eSpark-Backup/briacbarthes-phonecharger/Deliverables/Renderings/3D_Bottom_View.PNG

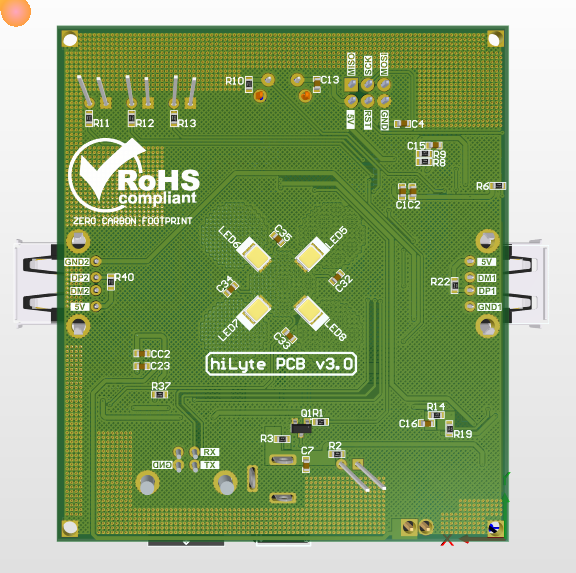
Deliverables/Renderings/3D_Bottom_View.PNG
