eSpark-Backup/briacbarthes-phonecharger/README.md

# BriacBarthes-PhoneCharger
To review and suggest further additions in client provided design of a Phone and Lamp Charger
### Circuit Issues and Proposed Corrections:
https://docs.google.com/document/d/1EhsSzwDODKwB_9vhH6Y4LQYS8pfnAFaaIl9aHzSk7XA/edit#
