eSpark-Backup/briacbarthes-phonecharger/Deliverables/Renderings/2D_Bottom_View.PNG

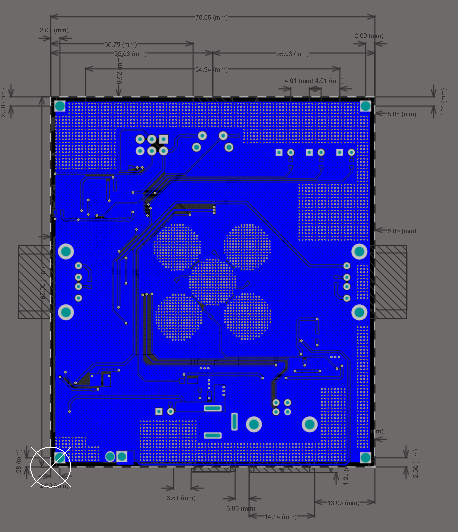
Deliverables/Renderings/2D_Bottom_View.PNG
