eSpark-Backup/briacbarthes-phonecharger/Deliverables/Renderings/2D_C_View.PNG

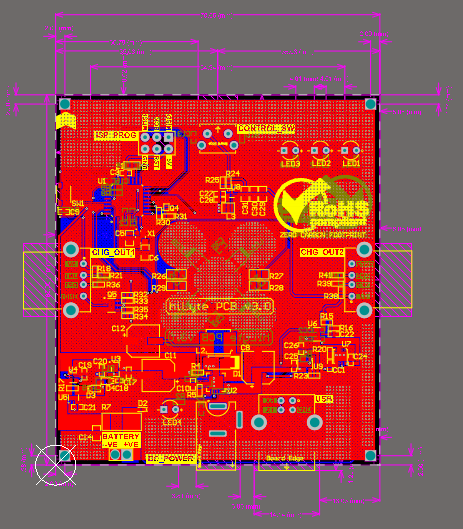
Deliverables/Renderings/2D_C_View.PNG
