eSpark-Backup/briacbarthes-phonecharger/Deliverables/Renderings/2D_Top_View.PNG

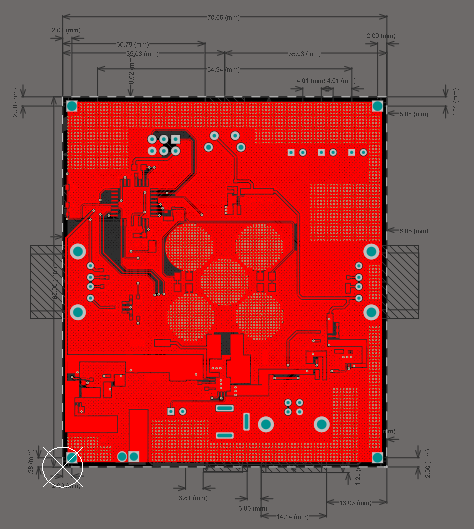
Deliverables/Renderings/2D_Top_View.PNG
