eSpark-Backup/briacbarthes-phonecharger/Deliverables/Renderings/Isometric_View.PNG

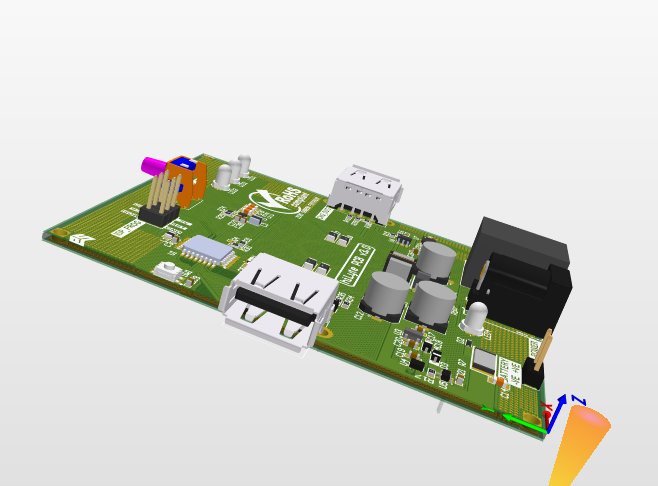
Deliverables/Renderings/Isometric_View.PNG
