eSpark-Backup/briacbarthes-phonecharger/Documents/Client-Files/WhatsApp Image 2021-10-05 at 18.15.51.jpeg

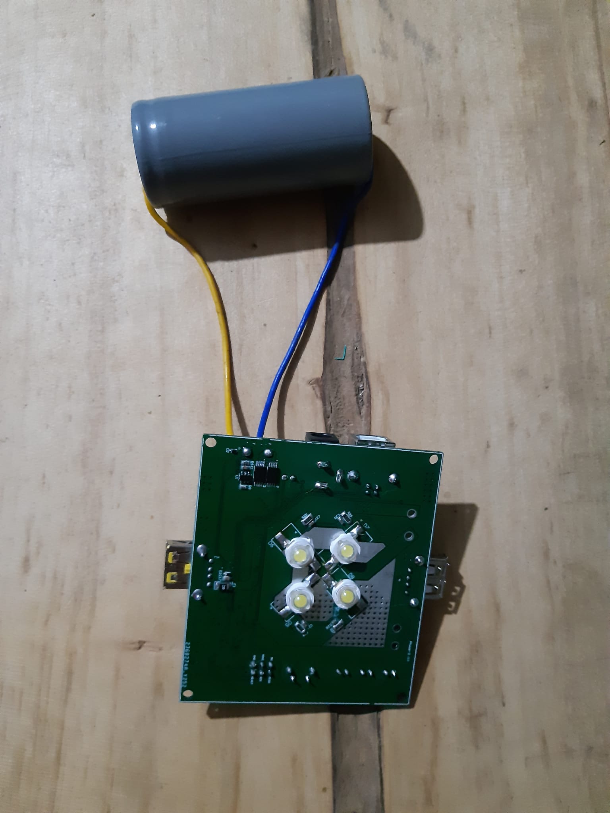
Documents/Client-Files/WhatsApp Image 2021-10-05 at 18.15.51.jpeg
