eSpark-Backup/briacbarthes-phonecharger/Documents/Client-Files/WhatsApp Image 2021-10-05 at 18.16.50.jpeg

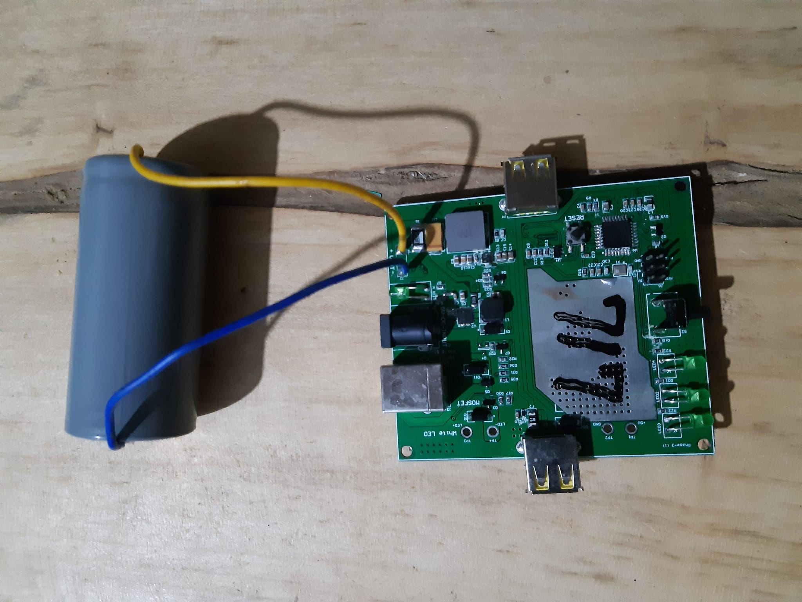
Documents/Client-Files/WhatsApp Image 2021-10-05 at 18.16.50.jpeg
