eSpark-Backup/briacbarthes-phonecharger/Documents/Dev-Files/Datasheet/FAgmp.png

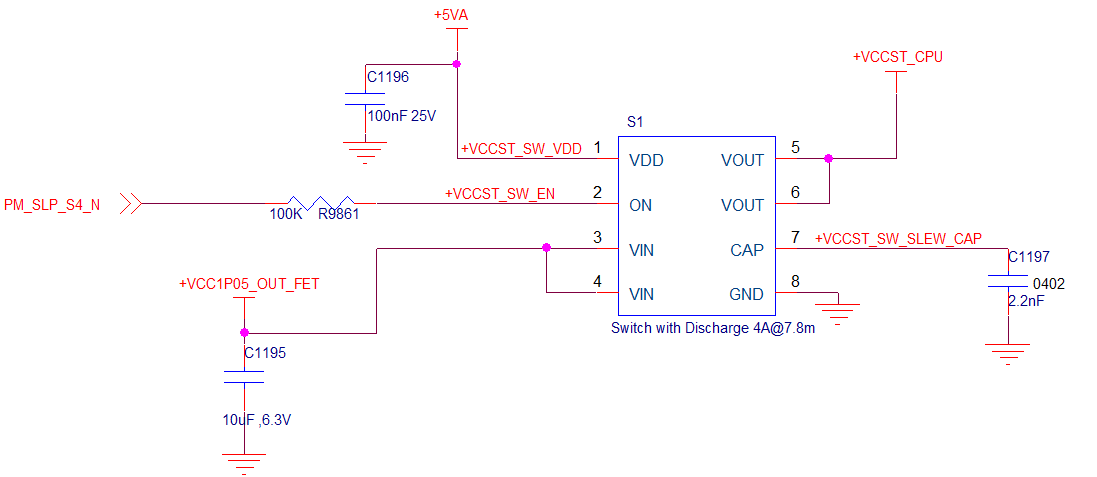
Documents/Dev-Files/Datasheet/FAgmp.png
