eSpark-Backup/briacbarthes-phonecharger/BOM/Client BOM.xlsx

Bill of Material (BOM) for Refrence Formate
S. No. | Components | Description | Designator | Footprint (Package) | Manufacturer Part Number | Manufacturer | LCSC Part No | Alternate | Value | LCSC/MOQ | Quantity (Per Board) | Quantity 10 | Quantity 20 | Quantity 500 | Quantity 1000 | Quantity 10000 | Unit Cost(10) | Total Cost(10) | Unit Cost (20 Boards) | Total Cost (20) | Unit Cost (500 Boards) | Total Cost (500) | Unit Cost (1000 Boards) | Total Cost (1000) | Unit Cost (10000 Boards) | Total Cost (10000) | Remarks
1 | Capacitor | CAP CER 0.1UF 50V X7R 0402 | C1,C10 | 0402 | 04025C104KAT2A | KYOCERA AVX | C110251 | 0402B104K500NT | 0.1uF | 50 | 1 | 50 | 50 | 550 | 1100 | 10500 | $0.0098 | $0.4900 | $0.0087 | $0.4350 | $0.0054 | $2.9700 | $0.0354 | $38.9400 | $0.0045 | $47.2500 | C10,wala part b same ha is lye merge kr dia 1 part no me
2 |  | Ceramic Capacitor,100nF,10V,0603 | C2, C17, C18, C19, C23, C24, C25, C26, C27, C28,C4, C8, C12, C20, C21, C22,Ce1,Ce2,Ce3,C31,C4 | 0603 | CC0603KRX7R6BB104 | YAGEO | C519438 | - | 100nF | 50 | 21 | 250 | 500 | 11000 | 22000 | 220000 | $0.0157 | $3.9250 | $0.0396 | $19.8000 | $0.0042 | $46.2000 | $0.0042 | $92.4000 | $0.0040 | $880.0000
3 |  | Ceramic Capacitor,22uF,10V,0805,X5R | C3, C9, C13, C14, C15 | 0805 | 0805X226M100NT | FH | C503482 | - | 22uF | 20 | 5 | 60 | 120 | 2650 | 5300 | 52000 | $0.0618 | $3.7080 | $0.0518 | $6.2160 | $0.0199 | $52.7350 | $0.0498 | $263.9400 | $0.0188 | $977.6000
4 |  | Tantalum capacitor 10uF 10V, CASE-A_3216 | C5, C6 | CASE-A_3216 | CA45-106K010AT | TANCAP | C327722 | - | 10uF | 5 | 2 | 25 | 45 | 1050 | 2100 | 21000 | $0.50750 | $12.6875 | $0.15750 | $7.0875 | $0.0880 | $92.4000 | $0.0764 | $160.4400 | $0.0739 | $1551.9000
5 |  | CAP CER 100PF 50V C0G 0603 | C7 | 0603 | CGA3E2C0G1H101JT0Y0N | TDK | C76709 | - | 100pF | 50 | 1 | 50 | 50 | 550 | 1050 | 10500 | $0.1159 | $5.7950 | $0.0159 | $0.7950 | $0.01 | $7.6450 | $0.09 | $94.2900 | $0.05 | $480.9000
6 |  | CAP TANT 150UF 10% 10V 2917 | C11 | CASE-D_7343 | T495D157K010ATE100 | KEMET | C122324 | - | 150uF | 1 | 1 | 12 | 23 | 525 | 1050 | 10200 | $0.7646 | $9.1752 | $0.7646 | $17.5858 | $0.6655 | $349.3875 | $0.6587 | $691.6350 | $0.6564 | $6695.2800
7 |  | CAP CER 10000PF 25V X7R 0603 | C16 | 0603 | 06033C103JAT4A | KYOCERA | C327204 |  | 10nF | 50 | 1 | 50 | 50 | 550 | 1100 | 10500 | $0.0549 | $2.7450 | $0.0049 | $0.2450 | $0.0039 | $2.1450 | $0.0655 | $72.0500 | $0.0236 | $247.8000
8 |  | CAP CER 1UF 25V X5R 0603 | Ce4 | 0603 | TMK107BLD105KA-T | Taiyo Yuden | C36577 | 0603F105M250NT | 1uF | 50 | 1 | 50 | 50 | 600 | 1050 | 10500 | $0.0285 | $1.4250 | $0.0768 | $3.8400 | $0.5500 | $330.0000 | $0.0466 | $48.9300 | $0.0741 | $778.0500
9 |  | Ceramic Capacitor,22pF,50V,0603 | C29, C30 | 0603 | FN18N220J500PSG | PSA | C525244 | - | 22pF | 100 | 2 | 100 | 100 | 1200 | 2200 | 21000 | $0.0031 | $0.3100 | $0.0031 | $0.3100 | $0.0023 | $2.7600 | $0.0823 | $181.0600 | $0.0545 | $1144.5000
10 | Diode | DIODE SCHOTTKY 40V 3A SMC | D1, D9, D10 | SMA | SS34 | onsemi | C8678 | - | - | 10 | 3 | 40 | 70 | 1600 | 3200 | 31500 | $0.0658 | $2.6320 | $0.0658 | $4.6060 | $0.0890 | $142.4000 | $0.0475 | $152.0000 | $0.0383 | $1206.4500
11 |  | TVS DIODE 5VWM 12.3VC SOD923 | D2, D3, D4 | SOD-923-2 | ESD9X5.0ST5G | onsemi | - | - | - | 10 | 3 | 35 | 70 | 1600 | 3100 | 30500 | $0.0369 | $1.2897 | $0.0369 | $2.5795 | $0.0236 | $37.7920 | $0.0297 | $91.9460 | $0.0224 | $684.4200
12 |  | Led Zpower Warm White 3000K 2SMD | D5, D6, D7, D8 | SMD/SMT | N42180-06-S2 | Seoul Semiconductor |  |  |  |  | 4 | 46 | 92 | 2300 | 4600 | 46000 |  | $0.0000 |  | $0.0000 |  | $0.0000 |  | $0.0000 |  | $0.0000
13 | Fuse | 6V 3.5A 1.5s SMD PTC Resettable Fuses | F1, F2 | Custom | SMD1206B200TF | Brightking | C269122 | - | - | 10 | 2 | 20 | 50 | 1050 | 2100 | 21000 | $0.0455 | $0.9100 | $0.0455 | $2.2750 | $0.0319 | $33.4950 | $0.0584 | $122.6400 | $0.0299 | $627.9000
14 | Inductor | 4.7uH ±20% 4A 26mΩ SMD,6x6x4.2mm Power Inductors RoHS | L1 | SMD,6x6x4.2mm | HPC6045NF-4R7MTH | TAI-TECH | C304373 | - | - | 5 | 1 | 10 | 25 | 525 | 1050 | 10500 | $0.0808 | $0.8080 | $0.0808 | $2.0200 | $0.05 | $28.8225 | $0.10 | $99.9600 | $0.05 | $544.9500
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
32 |  | Thick Film Resistor - 0.1ohm, 1%, 0.25W, 1206 | R24, R25, R26, R27 | 1206 | CR1206FR100P05R | Ever | C149672 | - | 0.1Ω | 50 | 4 | 50 | 100 | 2100 | 4200 | 41500 | $0.01 | $0.4650 | $0.01 | $0.9300 | $0.0088 | $18.4800 | $0.0069 | $28.9800 | $0.0162 | $672.3000
33 |  | RES SMD 400 OHM 0.1% 1/4W 1206 | RE3 | 1206 | RT1206BRD07400RL | YAGEO | C706413 | - | 400Ω | 5 | 1 | 10 | 25 | 525 | 1050 | 10500 | $0.0944 | $0.9440 | $0.0944 | $2.3600 | $0.0669 | $35.1225 | $0.0744 | $78.1200 | $0.0644 | $676.2000
34 | Switch | SPST 50mA @ 12VDC Top Actuated Round Button 160gf 4.5*4.5*5 Tactile Switch | S1 | 4.5X4.5X5mm_SMD | UK-B0206-G5-160-JZ | USAKRO | C620330 | - | - | 10 | 1 | 10 | 20 | 520 | 1050 | 10200 | $0.0560 | $0.5600 | $0.0660 | $1.3200 | $0.0496 | $25.7920 | $0.0677 | $71.0850 | $0.0358 | $365.1600
35 |  | SPST 50mA @ 12VDC Side operation Round Button Through Hole Tactile Switches | S2 | TH | SKHHLQA010 | ALPSALPINE | C125034 | - | - | 5 | 1 | 10 | 25 | 520 | 1050 | 10500 | $0.1308 | $1.3080 | $0.1378 | $3.4450 | $0.0868 | $45.1360 | $0.0838 | $87.9900 | $0.0855 | $897.7500
36 | Crystal | CRYSTAL 16.0000MHZ 12PF SMD | X1 | SMD-2520_4P | XXDPBISANF-16.000000 | Taitien |  |  |  |  | 1 | 12 | 23 | 575 | 1150 | 11500 |  | $0.0000 |  | $0.0000 |  | $0.0000 |  | $0.0000 |  | $0.0000
37 | IC | DW01A battery protection IC SOT-23-6 (Sunrom Product Code 4911) | U1 | SOT-23-6 | DW01A | PUOLOP | C351410 | - | - | 10 | 1 | 10 | 20 | 530 | 1050 | 10200 | $0.0604 | $0.6040 | $0.0684 | $1.3680 | $0.0466 | $24.6927 | $0.0789 | $82.8450 | $0.0383 | $390.6600
38 |  | QFN-16_4x4x065P PMIC - Battery Management RoHS | U2 | QFN-16_4x4x065P | TP5000-QFN16 | TOPPOWER | C51699 | - | - | 1 | 1 | 11 | 22 | 520 | 1050 | 10200 | $0.2844 | $3.1284 | $0.2874 | $6.3228 | $0.2790 | $145.0800 | $0.3429 | $360.0450 | $0.2416 | $2464.3200
39 |  | Dual N-Channel Mosfet TSSOP-8 (Sunrom Product Code 5292) | U3 | TSSOP-8 | FS8205A | Fortune | C16052 | - | - | 1 | 1 | 11 | 22 | 520 | 1050 | 10200 | $0.1683 | $1.8513 | $0.1898 | $4.1756 | $0.1498 | $77.8960 | $0.1159 | $121.6950 | $0.1650 | $1683.0000
40 |  | IC CURR SENSE 1 CIRCUIT SOT23-6 | U4 | SOT-23-6 | INA181A3IDBVR | Texas | - | - | - | 10 | 1 | 11 | 22 | 520 | 1110 | 11100 | $1.0900 | $11.9900 | $0.9700 | $21.3400 | $0.8954 | $465.6000 |  | $0.0000 |  | $0.0000
41 |  | IC REG BOOST 5.1V 6.5A 9VQFN | U5 | VQFN-9 | TPS61235PRWLR | Texas | - | - | - | 10 | 1 | 11 | 22 | 520 | 1050 | 10200 | $2.5030 | $27.5330 | $2.2114 | $48.6500 | $1.9239 | $1000.4200 | $2.4960 | $2620.8000 |  | $0.0000
42 |  | MICROCHIP - ATMEGA328P-AU. - MICROCONTROLLER MCU, 8 BIT, ATMEGA, 20MHZ, TQFP-32 | U6 | TQFP-32 | ATMEGA328P-AU | Microchip | C14877 | - | - | 1 | 1 | 11 | 22 | 510 | 1020 | 10100 | $3.8122 | $41.9342 | $3.8122 | $83.8684 | $3.6945 | $1884.1950 | $3.0587 | $3119.8740 | $3.0125 | $30426.2500
43 |  | IC OR CTRLR SRC SELECT 8TSSOP | U7 | 8-TSSOP | TISTPS2111APWR | Texas |  |  |  |  | 1 | 11 | 22 | 555 | 1110 | 11100 |  | $0.0000 |  | $0.0000 |  | $0.0000 |  | $0.0000 |  | $0.0000
44 |  | IC PWR SWITCH P-CHAN 1:1 4TMLF | U8 | 4-TMLF | MIC94082YFT-TR | Microchip | - | - | - | 65 | 1 | 65 | 65 | 520 | 1050 | 10200 | $0.8650 | $56.2250 | $0.9050 | $58.8250 | $0.8800 | $457.6000 | $0.7800 | $819.0000 | $0.8580 | $8751.6000
45 | Connector | CONN PWR JACK 2.1X5.5MM SOLDER | J1 | TH | 694106301002 | Würth |  |  |  |  | 1 | 10 | 20 | 500 | 1000 | 10000 |  | $0.0000 |  | $0.0000 |  | $0.0000 |  | $0.0000 |  | $0.0000
46 |  | USB B-type Female Right Angle PCB Mount | J3 | TH | Sunrom 3966 | Sunrom | - | - | - | 10 | 1 | 10 | 22 | 520 | 1050 | 10100 | $0.2200 | $2.2000 | $0.2200 | $4.8400 | $0.9100 | $473.2000 | $0.5440 | $571.2000 | $0.7000 | $7070.0000
47 |  | CONN RCPT USB2.0 TYPEA 4POS R/A | J4, J5 | TH | 292303-1 | TE | - | - | - | 60 | 2 | 60 | 60 | 1050 | 2100 | 20500 | $0.9070 | $54.4200 | $0.9872 | $59.2320 | $0.6650 | $698.2500 | $0.6997 | $1469.3700 | $0.6750 | $13837.5000
48 |  | Pin Header 6P 2 right-angle, P=2.54mm | J6 | TH 2.54MM | PZ254V-12-6P | XFCN | C492420 | - | - | 20 | 1 | 20 | 20 | 520 | 1160 | 10200 | $0.07 | $1.3020 | $0.06 | $1.1020 | $0.9900 | $514.8000 | $0.0579 | $67.1640 | $0.0178 | $181.5600
 |  |  |  |  |  |  |  |  |  |  | Total Component Cost |  |  |  |  |  |  | $265.21 |  | $407.84 |  | $8440.43 |  | $13198.70 |  | $90954.99
 |  |  |  |  |  |  |  |  |  |  | Single Board Cost |  |  |  |  |  |  | $26.52 |  | $20.39 |  | $16.88 |  | $13.20 |  | $9.10
