eSpark-Backup/briacbarthes-phonecharger/Deliverables/BOM/Client-BOM.xlsx

Bill of Material (BOM) for Briac
S. No. | Components | Description | Designator | Footprint (Package) | Manufacturer Part Number | Manufacturer | Alternate | Value | LCSC MOQ (1Board) | MOQ (5 boards) | MOQ (100 boards) | MOQ (1000 boards) | Quantity (per Board) | Quantity 5 | Quantity 100 | Quantity 1000 | Link | Unit Cost(5) | Total Cost(5) | Unit Cost (100 Boards) | Total Cost (100) | Unit cost (1000) | Total Cost(1000) | Remarks
1 | Capacitor | CAP CER 0.1UF 50V Y5V 0603 | C1, C2, C3, C4, C7, C9, C10, C13, C15, C20, C21, C22, C23, C24, C25, C26, C32, C33, C34, C35, CC1, CC2 | Cap0603 | CC0603ZRY5V9BB104 | Yageo | ----------- | 0.1uF | 100 | 200 | 2300 | 22500 | 22 | 110 | 2200 | 22000 | LCSC (https://lcsc.com/product-detail/Multilayer-Ceramic-Capacitors-MLCC-SMD-SMT_YAGEO-CC0603ZRY5V9BB104_C106221.html) | $0.0033 | $0.6600 | $0.0024 | $5.5200 | $0.0021 | $47.2500
2 |  | CAP CER 22UF 35V X5R 0805 | C5, C6, C14, C29, C30, C31 | Cap0805 | C2012X5R1V226MT000E | TDK Corporation | -------- | 22uF | 10 | 35 | 650 | 6100 | 6 | 30 | 600 | 6000 | LCSC (https://lcsc.com/product-detail/Multilayer-Ceramic-Capacitors-MLCC-SMD-SMT_TDK-C2012X5R1V226MT000E_C338080.html) | $0.2561 | $8.9635 | $0.2090 | $135.8500 | $0.2073 | $1264.5300
3 |  | CAP ALUM 10UF 20% 50V SMD | C8, C11, C12 | Custom | UWX1H100MCL1GB | Nichicon | -------- | 10uF | 5 | 20 | 350 | 3100 | 3 | 15 | 300 | 3000 | Custom Supplier (https://lcsc.com/product-detail/Aluminum-Electrolytic-Capacitors-SMD_Nichicon-UWX1H100MCL1GB_C134237.html) | $0.0830 | $1.6600 | $0.0609 | $21.3150 | $0.06 | $173.2900
4 |  | CAP CER 100PF 25V C0G/NPO 0603 | C16 | Cap0603 | CC0603JRNPO8BN101 | Yageo | -------- | 100pF | 50 | 50 | 150 | 1100 | 1 | 5 | 100 | 1000 | LCSC (https://lcsc.com/product-detail/Multilayer-Ceramic-Capacitors-MLCC-SMD-SMT_YAGEO-CC0603JRNPO8BN101_C519387.html) | $0.0040 | $0.2000 | $0.0040 | $0.6000 | $0.0031 | $3.4100
5 |  | CAP CER 1UF 25V Y5V 0603 | C17, C28 | Cap0603 | CC0603ZRY5V8BB105 | Yageo | -------- | 1uF | 50 | 50 | 250 | 2100 | 2 | 10 | 200 | 2000 | LCSC (https://lcsc.com/product-detail/Multilayer-Ceramic-Capacitors-MLCC-SMD-SMT_YAGEO-CC0603ZRY5V8BB105_C106848.html) | $0.0097 | $0.4850 | $0.0097 | $2.4250 | $0.0071 | $14.9100
6 |  | CAP CER 0402 2.2NF 25V C0G 5% | C18 | Cap 0402 | ~~C0402C222J3GEC7867~~ | KEMET | CC0402KRX7R8BB222 | 2.2nF | 100 | 100 | 200 | 1100 | 1 | 5 | 100 | 1000 | LCSC (https://lcsc.com/product-detail/Multilayer-Ceramic-Capacitors-MLCC-SMD-SMT_YAGEO-CC0402KRX7R8BB222_C541386.html) | $0.0015 | $0.1500 | $0.0015 | $0.3000 | $0.0012 | $1.3200
7 |  | CAP CER 10UF 25V X5R 0603 | C19, C27 | Cap0603 | CC0603MRX5R8BB106 | Yageo | -------- | 10uF | 5 | 15 | 230 | 2100 | 2 | 10 | 200 | 2000 | LCSC (https://lcsc.com/product-detail/Multilayer-Ceramic-Capacitors-MLCC-SMD-SMT_YAGEO-CC0603MRX5R8BB106_C596327.html) | $0.0906 | $1.3590 | $0.0683 | $15.7090 | $0.0648 | $136.0800
8 |  | CAP CER 1000PF 10V X7R 0603 | C39 | Cap0603 | ~~0603ZC102KAT2A~~ | KYOCERA AVX | CC0603KRX7R6BB102 | 1000pF | 50 | 50 | 150 | 1100 | 1 | 5 | 100 | 1000 | LCSC (https://lcsc.com/product-detail/Multilayer-Ceramic-Capacitors-MLCC-SMD-SMT_YAGEO-CC0603KRX7R6BB102_C519402.html) | $0.0043 | $0.2150 | $0.0043 | $0.6450 | $0.0033 | $3.6300
9 | Diode | 40V 500mV 3A 3A SMA Schottky Barrier Diodes (SBD) | D1 | SMA | SS34 | LGE | -------- | -------- | 10 | 10 | 120 | 1100 | 1 | 5 | 100 | 1000 | LCSC (https://lcsc.com/product-detail/Schottky-Barrier-Diodes-SBD_LGE-SS34_C432300.html) | $0.0755 | $0.7550 | $0.0579 | $6.9480 | $0.0422 | $46.4200
10 |  | SOD-523 ESD Protection Devices ROHS | D2 | SOD-523 | LESD5Z5.0CT1G | LRC | -------- | -------- | 20 | 20 | 120 | 1100 | 1 | 5 | 100 | 1000 | LCSC (https://lcsc.com/product-detail/span-style-background-color-ff0-ESD-span-Protection-Devices_LRC-LESD5Z5-0CT1G_C136167.html) | $0.0183 | $0.3660 | $0.0183 | $2.1960 | $0.0123 | $13.5300
11 |  | DIODE SCHOTTKY 20V 2A SOD323 | D3, D4 | SOD323 | SDM2U20SD3-7 | Diodes | -------- | -------- | 5 | 15 | 230 | 2100 | 2 | 10 | 200 | 2000 | LCSC (https://lcsc.com/product-detail/Schottky-Barrier-Diodes-SBD_Diodes-Incorporated-SDM2U20SD3-7_C460258.html) | $0.1087 | $1.6305 | $0.0772 | $17.7560 | $0.0723 | $151.8300
12 | Inductor | 500mA 10uH ±20% 320mΩ 0805 Inductors | L1 | Ind0805 | MGFL2012F100MT-LF | microgate | -------- | 10uH | 10 | 10 | 120 | 1100 | 1 | 5 | 100 | 1000 | LCSC (https://lcsc.com/product-detail/Inductors-SMD_microgate-MGFL2012F100MT-LF_C281113.html) | $0.0459 | $0.4590 | $0.0360 | $4.3200 | $0.0324 | $35.6400
13 |  | FIXED IND 4.7UH 3.1A 37.7MOHM SM | L2 | Custom | NR5040T4R7N | Taiyo Yuden | -------- | 4.7uH | 2 | 8 | 113 | 1100 | 1 | 5 | 100 | 1000 | Custom Supplier | $1.2000 | $9.6000 | $1.2000 | $135.6000 | $1.2000 | $1320.0000
14 |  | FIXED IND 1UH 3A 59 MOHM SMD | L3 | Custom | 1239AS-H-1R0M=P2 | Murata | -------- | 1uH | 5 | 10 | 120 | 1100 | 1 | 5 | 100 | 1000 | LCSC (https://lcsc.com/product-detail/Inductors-SMD_Murata-Electronics-1239AS-H-1R0M-P2_C167447.html) | $0.0703 | $0.7030 | $0.0512 | $6.1440 | $0.0442 | $48.6200
15 | LED | Yellow-Green 0402 Light Emitting Diodes | LED1, LED2, LED3, LED4 | LED 0402 | TZ-P2-0402YGTIA1-0.45T | TUOZHAN | -------- | -------- | 50 | 50 | 450 | 4100 | 4 | 20 | 400 | 4000 | LCSC (https://lcsc.com/product-detail/Light-Emitting-Diodes-LED_TUOZHAN-TZ-P2-0402YGTIA1-0-45T_C688878.html) | $0.0152 | $0.7600 | $0.0152 | $6.8400 | $0.0110 | $45.1000
16 |  | SMD LED 2835 Chips 1W 3V SMD | LED5, LED6, LED7, LED8 | 2835 LED | -------------- | XINGLIGHT | -------- | ------- | 50 | 50 | 450 | 4100 | 4 | 20 | 400 | 4000 | LCSC (https://lcsc.com/product-detail/Light-Emitting-Diodes-span-style-background-color-ff0-LED-span_XINGLIGHT-XL-2835UWC-02_C2843876.html) | $0.0086 | $0.4300 | $0.0086 | $3.8700 | $0.0059 | $24.1900
17 | Mosfet | SI2302 Series 20 3 A N-Ch Enhancement Mode Field Effect Transistor - SOT-23-3 | Q1 | SOT-23 | SI2302-TP | Micro | -------- | -------- | 10 | 10 | 200 | 1100 | 1 | 5 | 100 | 1000 | Aliexpress (https://www.aliexpress.com/item/32994205247.html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) | $0.0323 | $0.3230 | $0.0374 | $7.4800 | $0.0295 | $32.4500
18 |  | 2 N-Channel 466pF 10V 5.7nC 10V +150℃ (Tj) SOT23-6 MOSFETs | Q5 | SOT-23-6 | FS8205A | TECH | -------- | -------- | 10 | 10 | 110 | 1100 | 1 | 5 | 100 | 1000 | LCSC (https://lcsc.com/product-detail/MOSFETs_TECH-PUBLIC-FS8205A_C2830320.html) | $0.0615 | $0.6150 | $0.0453 | $4.9830 | $0.0363 | $39.9300
19 |  | Mosfet N-ch 12V 3.2A 3-PIN X2-DFN T/r | Q4 | X2-DFN1010-3 | DMN1045UFR4-7 | Diodes | -------- | -------- | 2 | 8 | 120 | 1100 | 1 | 5 | 100 | 1000 | Custom Supplier | $0.8000 | $6.4000 | $0.8000 | $96.0000 | $0.8000 | $880.0000
20 | Resistor | RES SMD 1K OHM 1% 1/10W 0603 | R1, R2, R30, R32, R34 | Res0603 | RC0603FR-071KL | YAGEO | -------- | 1K | 100 | 100 | 600 | 5200 | 5 | 25 | 500 | 5000 | LCSC (https://lcsc.com/product-detail/Chip-Resistor-Surface-Mount_YAGEO-RC0603FR-071KL_C22548.html) | $0.0012 | $0.1200 | $0.0012 | $0.7200 | $0.0009 | $4.6800
21 |  | RES SMD 100K OHM 1% 1/10W 0603 | R3, R25, R31, R33, R35, R37 | Res0603 | RC0603FR-07100KL | YAGEO | -------- | 100K | 100 | 100 | 700 | 6200 | 6 | 30 | 600 | 6000 | LCSC (https://lcsc.com/product-detail/Chip-Resistor-Surface-Mount_YAGEO-RC0603FR-07100KL_C14675.html) | $0.0011 | $0.1100 | $0.0011 | $0.7700 | $0.0008 | $4.9600
22 |  | RES 0.05 OHM 1% 1/10W 0603 | R4 | Res0603 | ~~WSL0603R0500FEA~~ | Vishay Dale | RTT03R050FTP | 0.05R | 50 | 50 | 150 | 1100 | 1 | 5 | 100 | 1000 | LCSC (https://lcsc.com/product-detail/Chip-span-style-background-color-ff0-Resistor-span-Surface-Mount_RALEC-RTT03R050FTP_C158895.html) | $0.0092 | $0.4600 | $0.0092 | $1.3800 | $0.0069 | $7.5900
23 |  | RES SMD 0R, 1%, 0.1W, 0603 | R5 | Res0603 | RC0603FR-070RL | YAGEO | -------- | 0R | 100 | 100 | 200 | 1100 | 1 | 5 | 100 | 1000 | LCSC (https://lcsc.com/product-detail/Chip-Resistor-Surface-Mount_YAGEO-RC0603FR-070RL_C100044.html) | $0.0011 | $0.1100 | $0.0011 | $0.2200 | $0.0008 | $0.8800
24 |  | RES SMD 10K OHM 5% 1/10W 0603 | R6, R10, R15, R16, R17, R19, R23 | Res0603 | AC0603JR-0710KL | YAGEO | -------- | 10K | 100 | 100 | 800 | 7100 | 7 | 35 | 700 | 7000 | LCSC (https://lcsc.com/product-detail/Chip-Resistor-Surface-Mount_YAGEO-AC0603JR-0710KL_C140867.html) | $0.0014 | $0.1400 | $0.0014 | $1.1200 | $0.0010 | $7.1000
25 |  | RES 0.001 OHM 5% 2W 2512 | R7 | RES 2512 | PA2512JKF7W0R001E | YAGEO | -------- | 0.001R | 5 | 10 | 120 | 1100 | 1 | 5 | 100 | 1000 | LCSC (https://lcsc.com/product-detail/Chip-Resistor-Surface-Mount_YAGEO-PA2512JKF7W0R001E_C728356.html) | $0.1472 | $1.4720 | $0.1131 | $13.5720 | $0.0825 | $90.7500
26 |  | RES SMD 12K OHM 1% 1/10W 0603 | R8 | Res0603 | ERJ3EKF1202V | Panasonic | -------- | 12K | 50 | 50 | 150 | 1100 | 1 | 5 | 100 | 1000 | LCSC (https://lcsc.com/product-detail/Chip-Resistor-Surface-Mount_PANASONIC-ERJ3EKF1202V_C400645.html) | $0.0084 | $0.4200 | $0.0084 | $1.2600 | $0.0062 | $6.8200
27 |  | RES SMD 33K OHM 1% 1/10W 0603 | R9 | Res0603 | AC0603FR-0733KL | YAGEO | -------- | 33K | 100 | 100 | 200 | 1100 | 1 | 5 | 100 | 1000 | LCSC (https://lcsc.com/product-detail/Chip-Resistor-Surface-Mount_YAGEO-AC0603FR-0733KL_C138282.html) | $0.0026 | $0.2600 | $0.0026 | $0.5200 | $0.0020 | $2.2000
28 |  | RES SMD 3.3K OHM 1% 1/10W 0603 | R11, R12, R13 | Res0603 | RC0603FR-073K3L | YAGEO | -------- | 3.3K | 100 | 100 | 400 | 3100 | 3 | 15 | 300 | 3000 | LCSC (https://lcsc.com/product-detail/Chip-Resistor-Surface-Mount_YAGEO-RC0603FR-073K3L_C108078.html) | $0.0014 | $0.1400 | $0.0014 | $0.5600 | $0.0011 | $3.4100
29 |  | RES 470K OHM 5% 1/10W 0603 | R14 | Res0603 | RC0603JR-07470KL | YAGEO | -------- | 470K | 100 | 100 | 200 | 1100 | 1 | 5 | 100 | 1000 | LCSC (https://lcsc.com/product-detail/Chip-Resistor-Surface-Mount_YAGEO-RC0603JR-07470KL_C115418.html) | $0.0015 | $0.1500 | $0.0015 | $0.3000 | $0.0012 | $1.3200
30 |  | RES SMD 47K Ohm 1% 0.2W(1/5W) 0603 | R18, R21, R22, R36, R38, R39, R40, R41 | Res0603 | ERJP03F4702V | PANASONIC | -------- | 47K | 10 | 50 | 830 | 8200 | 8 | 40 | 800 | 8000 | LCSC (https://lcsc.com/product-detail/Chip-Resistor-Surface-Mount_PANASONIC-ERJP03F4702V_C278670.html) | $0.0350 | $1.7500 | $0.0256 | $21.2480 | $0.0235 | $192.7000
31 |  | RES 330 OHM 0.5% 1/10W 0603 SMD | R20 | Res0603 | ERJU3RD3300V | Panasonic | -------- | 330R | 10 | 10 | 120 | 1100 | 1 | 5 | 100 | 1000 | LCSC (https://lcsc.com/product-detail/Chip-Resistor-Surface-Mount_PANASONIC-ERJU3RD3300V_C491170.html) | $0.0357 | $0.3570 | $0.0275 | $3.3000 | $0.0245 | $26.9500
32 |  | RES SMD 732kOhm 1% 0603 | R24 | Res0603 | AC0603FR-07732KL | YAGEO | -------- | 732K | 100 | 100 | 200 | 1100 | 1 | 5 | 100 | 1000 | LCSC (https://lcsc.com/product-detail/Chip-Resistor-Surface-Mount_YAGEO-AC0603FR-07732KL_C228042.html) | $0.0025 | $0.2500 | $0.0025 | $0.5000 | $0.0019 | $2.0900
33 |  | RES SMD 1206 0.1 Ohm 1% 1W ±100ppm/°C | R26, R27, R28, R29 | Res-1206 | ERJ8BWFR100V | Panasonic | -------- | 100m | 10 | 30 | 450 | 4100 | 4 | 20 | 400 | 4000 | LCSC (https://lcsc.com/product-detail/Chip-Resistor-Surface-Mount_PANASONIC-ERJ8BWFR100V_C411236.html) | $0.0676 | $2.0280 | $0.0463 | $20.8350 | $0.0409 | $167.6900
34 | Switch | 3mm 2mm Round Button 50mA Top3.65mm SPST 12V SMD Tactile Switches | SW1 | Custom | TS-1185EC-C-D-B | XKB | -------- | -------- | 10 | 10 | 120 | 1100 | 1 | 5 | 100 | 1000 | LCSC (https://lcsc.com/product-detail/Tactile-Switches_XKB-Connectivity-TS-1185EC-C-D-B_C318893.html) | $0.0259 | $0.2590 | $0.0187 | $2.2440 | $0.0161 | $17.7100
35 |  | Tactile Switches 6.0x6.0x8.35mm 100gf | SW2 | Custom | SKHHLQA010 | Alps Alpine | -------- | -------- | 2 | 10 | 120 | 1100 | 1 | 5 | 100 | 1000 | Chipmall (https://www.chipmall.com/product_detail/ALPS/Tactile-Switches/SKHHLQA010_1757321.html) | $0.1051 | $1.0509 | $0.1051 | $12.6102 | $0.1051 | $115.5935
36 | IC | IC MCU 8BIT 32KB FLASH 32TQFP | U1 | 32 TQFP (7X7) | ATMEGA328P-AU | Microchip | -------- | -------- | 2 | 6 | 105 | 1020 | 1 | 5 | 100 | 1000 | LCSC (https://lcsc.com/product-detail/ATMEL-AVR_Microchip-Tech-ATMEGA328P-AU_C14877.html) | $15.7751 | $94.6506 | $15.7751 | $1656.3855 | $15.7751 | $16090.6020
37 |  | QFN-16_4x4x065P Battery Management ICs ROHS | U2 | 16-QFN (4x4) | TP5000_QFN16 | TOPPOWER | -------- | -------- | 2 | 6 | 105 | 1020 | 1 | 5 | 100 | 1000 | LCSC (https://lcsc.com/product-detail/Battery-Management-ICs_TOPPOWER-Nanjing-Extension-Microelectronics-TP5000-QFN16_C51699.html) | $0.3373 | $2.0238 | $0.2110 | $22.1550 | $0.2002 | $204.2040
38 |  | IC SUPERVISOR 1 CHANNEL 3SSOP | U3 | 3-SSOP | BD48K29G-TL | Rohm | -------- | -------- | 2 | 6 | 105 | 1020 | 1 | 5 | 100 | 1000 | Custom supplier | $1.1150 | $6.6900 | $1.1150 | $117.0750 | $1.1150 | $1137.3000
39 |  | IC PWR SWITCH N-CHAN 1:1 8TDFN | U4 | 8-FC-TDFN (1.5x2) ' | SLG7NT402V | Dialog | -------- | -------- | 2 | 6 | 105 | 1020 | 1 | 5 | 100 | 1000 | Custom supplier | $2.0710 | $12.4260 | $2.0710 | $217.4550 | $2.0710 | $2112.4200
40 |  | IC INVERTER OD 1CH 1-INP SC70-5 | U5 | SC-70-5 | NC7SZ05P5X | onsemi | -------- | -------- | 2 | 6 | 105 | 1020 | 1 | 5 | 100 | 1000 | Custom supplier | $0.4780 | $2.8680 | $0.4780 | $50.1900 | $0.4780 | $487.5600
41 |  | IC CURR SENSE 1 CIRCUIT SOT23-6 | U6 | SOT-23-6 | INA181A3IDBVR | Texas Instruments | -------- | -------- | 2 | 6 | 105 | 1020 | 1 | 5 | 100 | 1000 | Custom supplier | $0.6370 | $3.8220 | $0.6370 | $66.8850 | $0.6370 | $649.7400
42 |  | IC OR CTRLR SRC SELECT 8SON | U7 | 8-SON (3x3) | TPS2115ADRBTG4 | Texas Instruments | -------- | -------- | 2 | 6 | 105 | 1020 | 1 | 5 | 100 | 1000 | Custom supplier | $3.1850 | $19.1100 | $3.1850 | $334.4250 | $3.1850 | $3248.7000 | Rates from Supplier on Alibaba
43 |  | FINISH GOODS FOR TPS61023 | U8 | SOT-563 | TPS61023DRLR | Texas Instruments | -------- | -------- | 2 | 6 | 110 | 1020 | 1 | 5 | 100 | 1000 | Custom supplier | $3.1850 | $19.1100 | $3.1850 | $350.3500 | $3.1850 | $3248.7000
44 |  | IC PWR DRIVER P-CHAN 1:1 6TSOP | U9 | 6-TSOP | NTGD1100LT1G | ON Semiconductor | -------- | -------- | 2 | 6 | 110 | 1020 | 1 | 5 | 100 | 1000 | Custom supplier | $0.9560 | $5.7360 | $0.9560 | $105.1600 | $0.9560 | $975.1200
45 | Crytal | 16MHz SMD Crystal Resonator 10pF 80Ω ±10ppm | X1 | Custom | Q24FA20H0051200 | Seiko | ------------ | ----- | 2 | 6 | 105 | 1020 | 1 | 5 | 100 | 1000 | LCSC (https://lcsc.com/product-detail/Crystals_Seiko-Epson-Q24FA20H0051200_C255947.html) | $0.2857 | $1.7142 | $0.1459 | $15.3195 | $0.1398 | $142.5960
46 | Connector | 7A Jack DCPowerReceptacle 4.3mm 1.65mm | J1 | Custom | DC-C024E-7A-1.65 | XKB | ----------- | ------ |  |  | 105 | 1020 | 1 | 5 | 100 | 1000 | LCSC (https://lcsc.com/product-detail/AC-DC-Power-Connectors_XKB-Connectivity-DC-C024E-7A-1-65_C397335.html) | $0.7448 | $0.0000 | $0.4433 | $46.5465 | $0.4190 | $427.3800 | Less Stock on LCSC
47 |  | USB - Type A 4 USB 2.0 Female THT | J2, J3 | Custom | 901-141A1011D10100 | Jing | -------- | -------- | 10 | 10 | 210 | 2020 | 2 | 10 | 200 | 2000 | LCSC (https://lcsc.com/product-detail/USB-Connectors_Jing-Extension-of-the-Electronic-Co-901-141A1011D10100_C42665.html) | $0.0447 | $0.4470 | $0.0339 | $7.1190 | $0.0299 | $60.3980
48 |  | USB - Type B 4 USB 2.0 Female Through Hole | J4 | Custom | U241-041N-1BR85-1 | XKB | -------- | -------- | 5 | 10 | 110 | 1020 | 1 | 5 | 100 | 1000 | LCSC (https://lcsc.com/product-detail/USB-Connectors_XKB-Connectivity-U241-041N-1BR85-1_C397338.html) | $0.1165 | $1.1650 | $0.0841 | $9.2510 | $0.0694 | $70.7880
49 |  | CONN HEADER VERT 6POS 2.54MM | P1 | HDR1X6 | 61300611121 | Würth | -------- | -------- | 10 | 10 | 110 | 1020 | 1 | 5 | 100 | 1000 | LCSC (https://lcsc.com/product-detail/Pin-Headers_Shenzhen-Kinghelm-Elec-KH-2-54PH180-1X6P-L11-5_C2905486.html) | $0.0549 | $0.5490 | $0.0405 | $4.4550 | $0.0352 | $35.9040
50 |  | CONN HEADER VERT 2POS 2.54MM | P2 | HDR1X2 | 826629-2 | TE Connectivity | -------- | -------- | 5 | 10 | 110 | 1020 | 1 | 5 | 100 | 1000 | LCSC (https://lcsc.com/product-detail/Pin-Headers_TE-Connectivity-826629-2_C86471.html) | $0.1085 | $1.0850 | $0.1104 | $12.1440 | $0.0811 | $82.7220
 |  |  |  |  |  |  |  |  |  |  |  |  |  | Total Component Cost |  |  |  |  | $216.21 |  | $3570.58 |  | $33908.71
 |  |  |  |  |  |  |  |  |  |  |  |  |  | Single Board Cost |  |  |  |  | $43.2415 |  | $35.71 |  | $33.91
 |  |  |  |  |  |  |  |  |  |  |  |  |  |  |  | Aliexpress Shipping cost |  |  | $8.08 |  | $242.49 |  | $1307.35
 |  |  |  |  |  |  |  |  |  |  |  |  |  |  |  | Total Cost With Delivery |  |  | $224.29 |  | $3813.07 |  | $35216.06
