eSpark-Backup/briacbarthes-phonecharger/Documents/Client-Files/BOM_Hilyte_V3_1_1.xlsx

Designator | Value | Case/Package | Manufacturer Part Number | Quantity |  | Description | 100pc ( $ ) | 200 pc | 500pc | 1000pc | 10000pc
C1 | 100nF | 0402 | 04025C104KAT2A | 1 | 10 | Ceramic Capacitor,100nF,0402 | 0.08219178082 | 0.07534246575 | 0.04109589041 | 0.03424657534 | 0.01369863014
C2, C17, C18, C19, C23, C24, C25, C26, C27, C28,C4, C8, C12, C20, C21, C22 | 100nF | 0603 | CC0603KRX7R6BB104 | 16 | 160 | Ceramic Capacitor,100nF,10V,0603 | 0.1643835616 | 0.1506849315 | 0.08219178082 | 0.06849315068 | 0.04109589041
C3, C9, C13, C14, C15 | 22uF | 0805 | 0805X226M100NT | 5 | 50 | Ceramic Capacitor,22uF,10V,0805,X5R | 0.1917808219 | 0.1780821918 | 0.09589041096 | 0.08219178082 | 0.05479452055
C5, C6 | 10uF | CASE-A_3216 | CA45-106K010AT | 2 | 20 | Tantalum capacitor 10uF 10V, CASE-A_3216 | 0.3424657534 | 0.301369863 | 0.2465753425 | 0.2054794521 | 0.1369863014
C7 | 100pF | 0603 | CGA3E2C0G1H101JT0Y0N | 1 | 10 | Ceramic Capacitor,100pF,50V,C0G/NP0,0603 | 0.04109589041 | 0.03424657534 | 0.02191780822 | 0.01917808219 | 0.01369863014
C10 | 0.1uF | 0805 | 0402X104K250CT | 1 | 10 | Ceramic Capacitor,0.1uF,25V,0805,X5R | 0.04109589041 | 0.03424657534 | 0.02191780822 | 0.01917808219 | 0.01369863014
C11 | 150uF | CASE-D_7343 | T495D157K010ATE100/TPSC157K010R0150 | 1 | 10 | Tantalum capacitor 150uF 10V, CASE-D_7343 | 0.5479452055 | 0.4794520548 | 0.3698630137 | 0.2739726027 | 0.1643835616
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
 |  |  |  |  |  | PCB testing & Programming | 1.369863014 | 1.369863014 | 1.095890411 | 0.9589041096 | 0.6849315068
 |  |  |  |  |  |  | 15.89726027 | 14.55479452 | 10.94109589 | 9.250684932 | 6.01369863
 |  |  |  |  |  | This Pricing is valid up to 3 days after
