eSpark-Backup/briacbarthes-phonecharger/Documents/Dev-Files/Part Selection.xlsx

S.No | Component Name | Description | Manufacturer Part Number | Digikey Alternate | Value | Link | Remarks
1 | Ics | 24V 2A SOT-23-6 DC-DC Converters ROHS | SDB628 | LMR62014XMF/NOPB |  | LCSC (https://lcsc.com/product-detail/span-style-background-color-ff0-DC-DC-span-Converters_SHOUDING-SDB628_C77805.html) | Alternate IC available on both sites
2 |  | QFN-16_4x4x065P Battery Management ICs ROHS | TP5000-QFN16 | MCP73123T-22SI/MF |  | LCSC (https://lcsc.com/product-detail/Battery-Management-ICs_TOPPOWER-Nanjing-Extension-Microelectronics-TP5000-QFN16_C51699.html)
3 |  | 4A Power switch |  | SLG7NT402V |  | DigiKey (https://www.digikey.com/en/products/detail/dialog-semiconductor-gmbh/SLG7NT402V/7562906) | Available on sites other than LCSC
4 |  | 2A Source Selector |  | TPS2115ADRBTG4 |  | Worldway (https://www.worldwayelec.com/pro/texas-instruments/tps2115adrbtg4/5780752?from=octopart) | Also available on Aliexpress and chipfind
5
6 |  | IC INVERTER OD 1CH 1-INP SC70-5 |  | NC7SZ05P5X |  | LCSC (https://lcsc.com/product-detail/Inverters_onsemi-NC7SZ05P5X_C457639.html)
7 |  |  |  | XC61CN2502MR
8
9 | LED LAMP | 1W LED |  | - |  | Aliexpress (https://nl.aliexpress.com/item/32975360262.html) | 1W 2835 package warm light LED
10 | Connector | DC barrel Jack | DC-C024E-7A-1.65 | - |  | LCSC (https://lcsc.com/product-detail/AC-DC-Power-Connectors_XKB-Connectivity-DC-C300-5-5A-2-5_C388630.html)
11 |  | USB - Type A 4 USB 2.0 Female 1.5A - USB Connectors ROHS | 901-141A1011D10100 | - |  | LCSC (https://lcsc.com/product-detail/span-style-background-color-ff0-USB-span-Connectors_Jing-Extension-of-the-Electronic-Co-901-141A1011D10100_C42665.html)
12 |  | USB - Type B 4 USB 2.0 Female Through Hole USB Connectors ROHS | U241-041N-1BR85-1 | - |  | LCSC (https://lcsc.com/product-detail/span-style-background-color-ff0-USB-span-Connectors_XKB-Connectivity-U241-041N-1BR85-1_C397338.html)
