eSpark-Backup/briacbarthes-phonecharger/Deliverables/Supporting Files/Briac_Charger.step

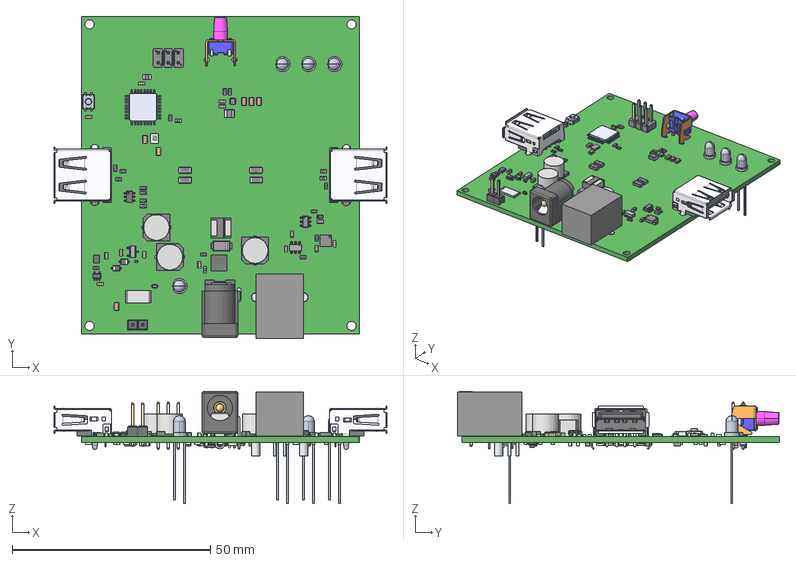
[picture p15: CAD file, 2022-02-23]
Deliverables/Supporting Files/Briac_Charger.step
83.9 x 81.2 x 28.3 mm
67997-206HLF--3DModel-STEP-56544
20410UYOCS530A3 x 4
6941xx301002
694106301002_PinContact
6941xx301002_Back
6941xx301002_PinContact2
6941xx301002_PinLame
6941xx301002_PinBis
User_Library-RESC1608X05N x 36
pppp
User_Library-LED_2835_Samsung_SPMWH1228 x 4
User_Library-SOD-523F
1239AS-H-1R0M=P2
IND_TAIYO_NR5040_TAY
Leads x 6
User_Library-DO-214AC_SMA
User_Library-sot353
User_Library-CRY_2520
TSOP6_1P70X3P10_ONS
TPS61023DRLR
TPS2115ADRBTG4
INA181A3IDBVR
SSOP3_ROM
ALSRobot-QFN16_4x4
ATMEGA328P-AU--3DModel-STEP-56544
skhhlqa010
ts-1185ec-c-d-b
User_Library-1206_SMD_Resistor x 4
CircuitWorks-RESISTOR_2512
User_Library-SOT23-6-2
SOT-23_MCC
User_Library-Header1x2_Header1_1 x 2
usb_2_a_90 x 2
User_Library-SOD323-1 x 2
User_Library-CAPC1608X09 x 27
User_Library-0805_SMD_Capacitor x 6
User_Library-Capacitor_0402
PCAP_6_3x5_4-ELECT_NCA x 3
