eSpark-Backup/briacbarthes-phonecharger/(list of files, cad)

Other CAD files:
Deliverables/Supporting Files/Briac_Charger.DWG
