eSpark-Backup/briacbarthes-phonecharger/Documents/Dev-Files/PCB Review/Issue-1.PNG

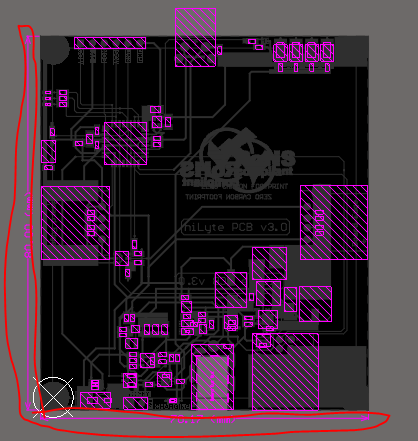
Documents/Dev-Files/PCB Review/Issue-1.PNG
