eSpark-Backup/briacbarthes-phonecharger/Documents/Dev-Files/PCB Review/Issue-2.PNG

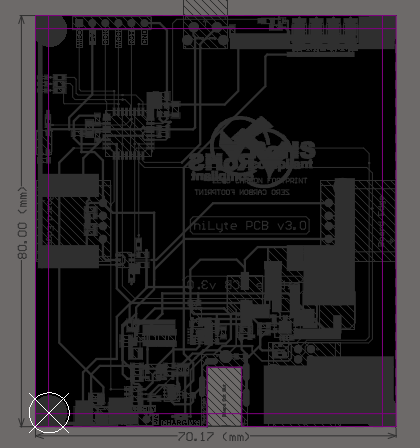
Documents/Dev-Files/PCB Review/Issue-2.PNG
