eSpark-Backup/briacbarthes-phonecharger/Documents/Dev-Files/PCB Review/Issue-3.PNG

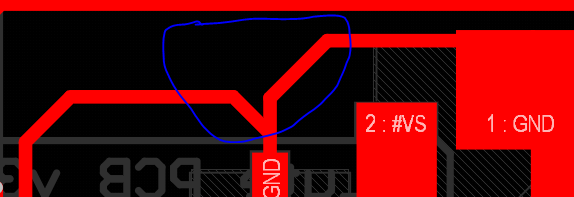
Documents/Dev-Files/PCB Review/Issue-3.PNG
