eSpark-Backup/briacbarthes-phonecharger/Documents/Dev-Files/PCB Review/Issue-4.PNG

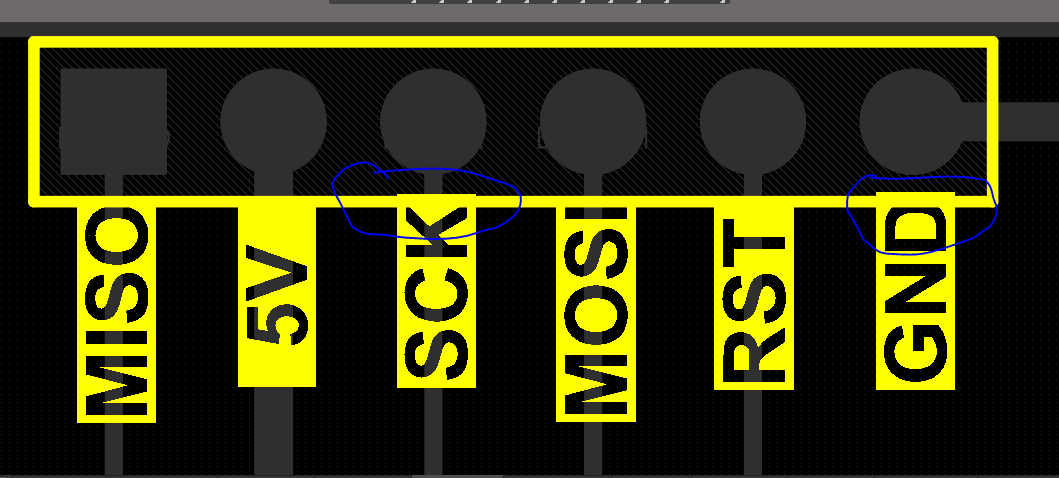
Documents/Dev-Files/PCB Review/Issue-4.PNG
