eSpark-Backup/briacbarthes-phonecharger/Deliverables/Schematics/Phone_Charger.pdf

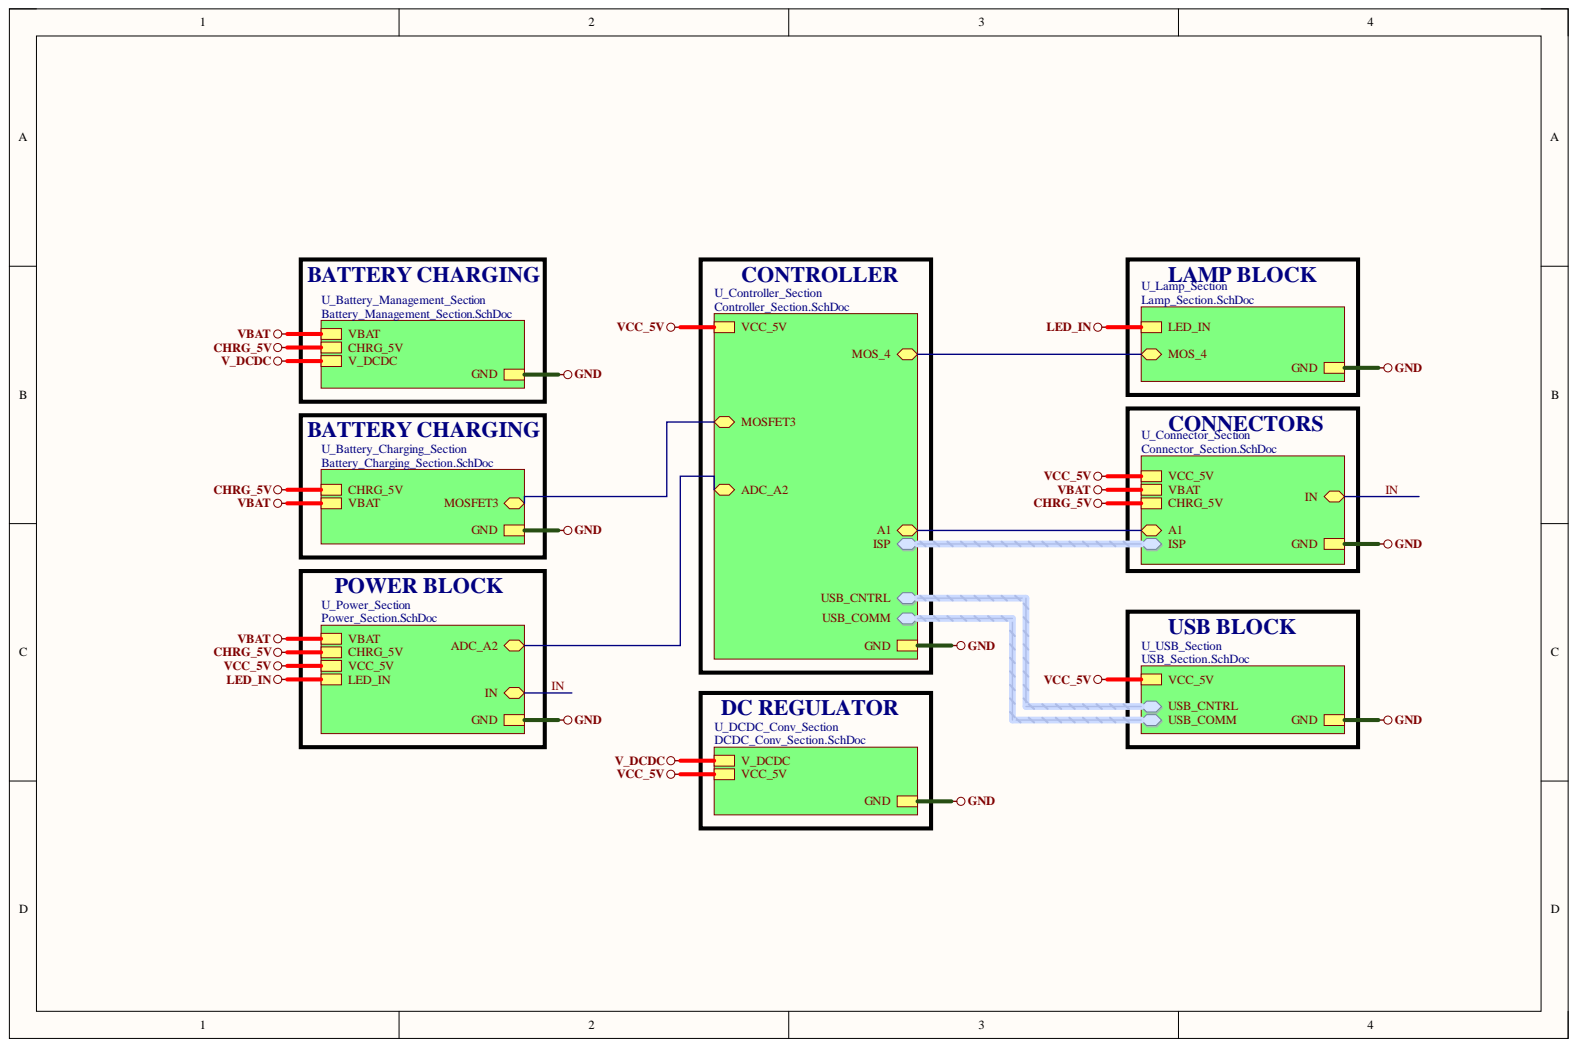
[picture p21: page 1]

POWER BLOCK U_Power_Section Power_Section.SchDoc

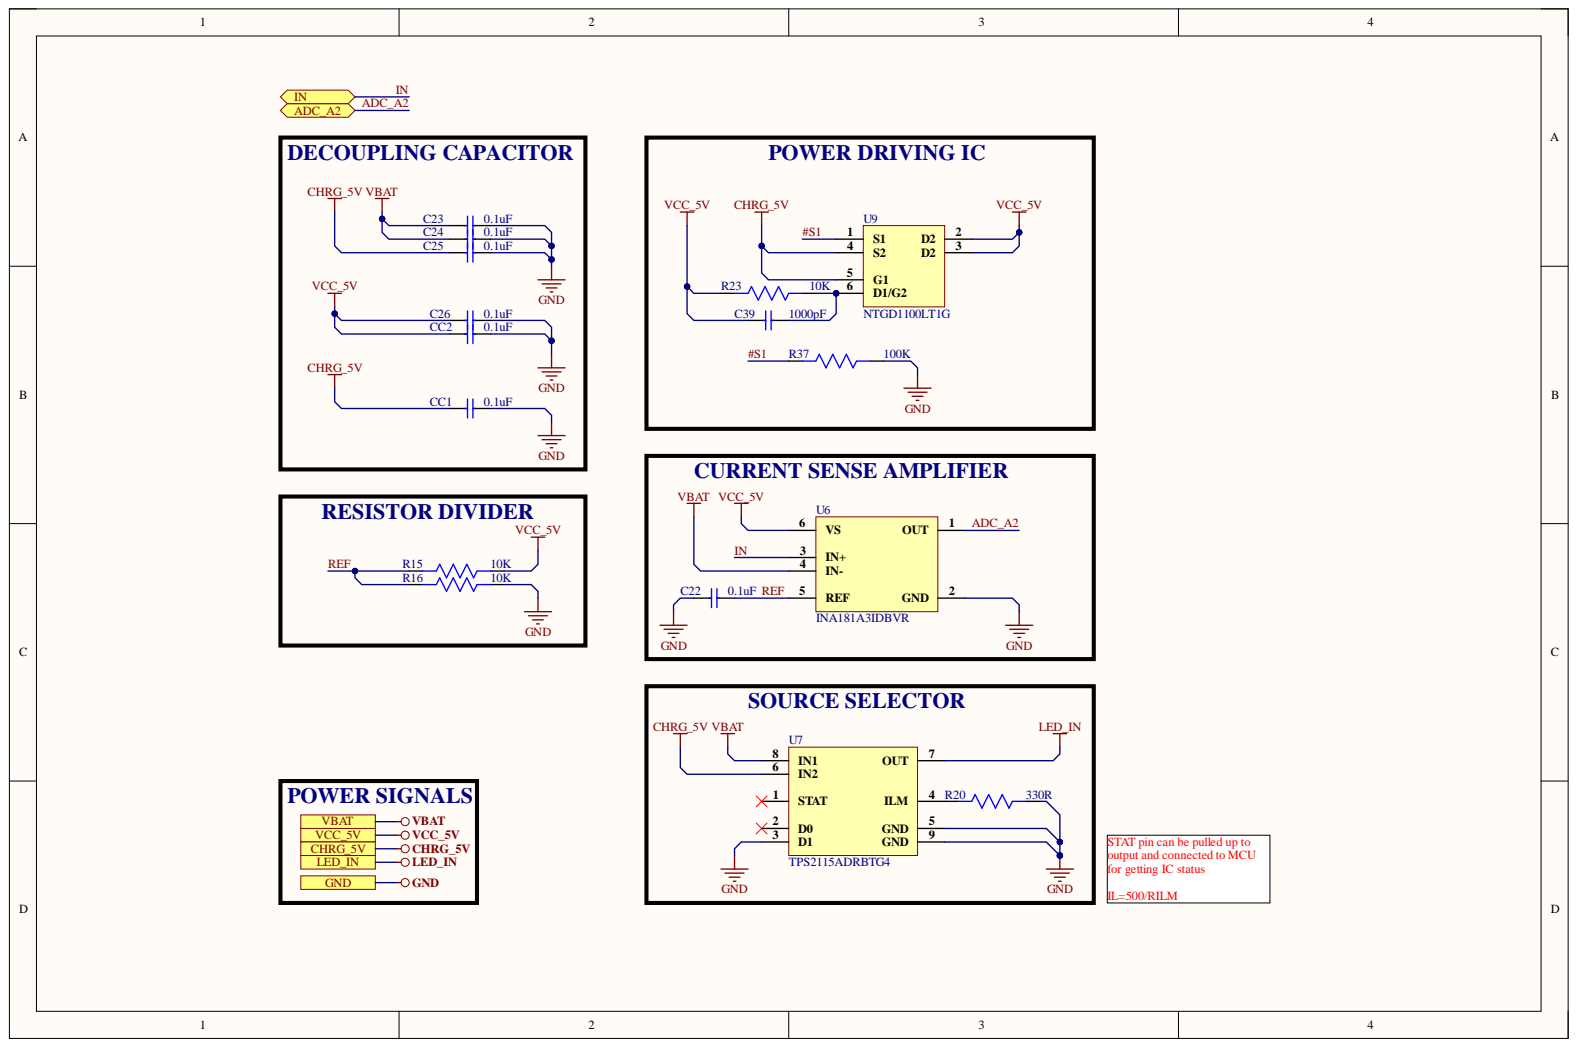
[picture p22: page 2]

STAT pin can be pulled up to
output and connected to MCU
for getting IC status

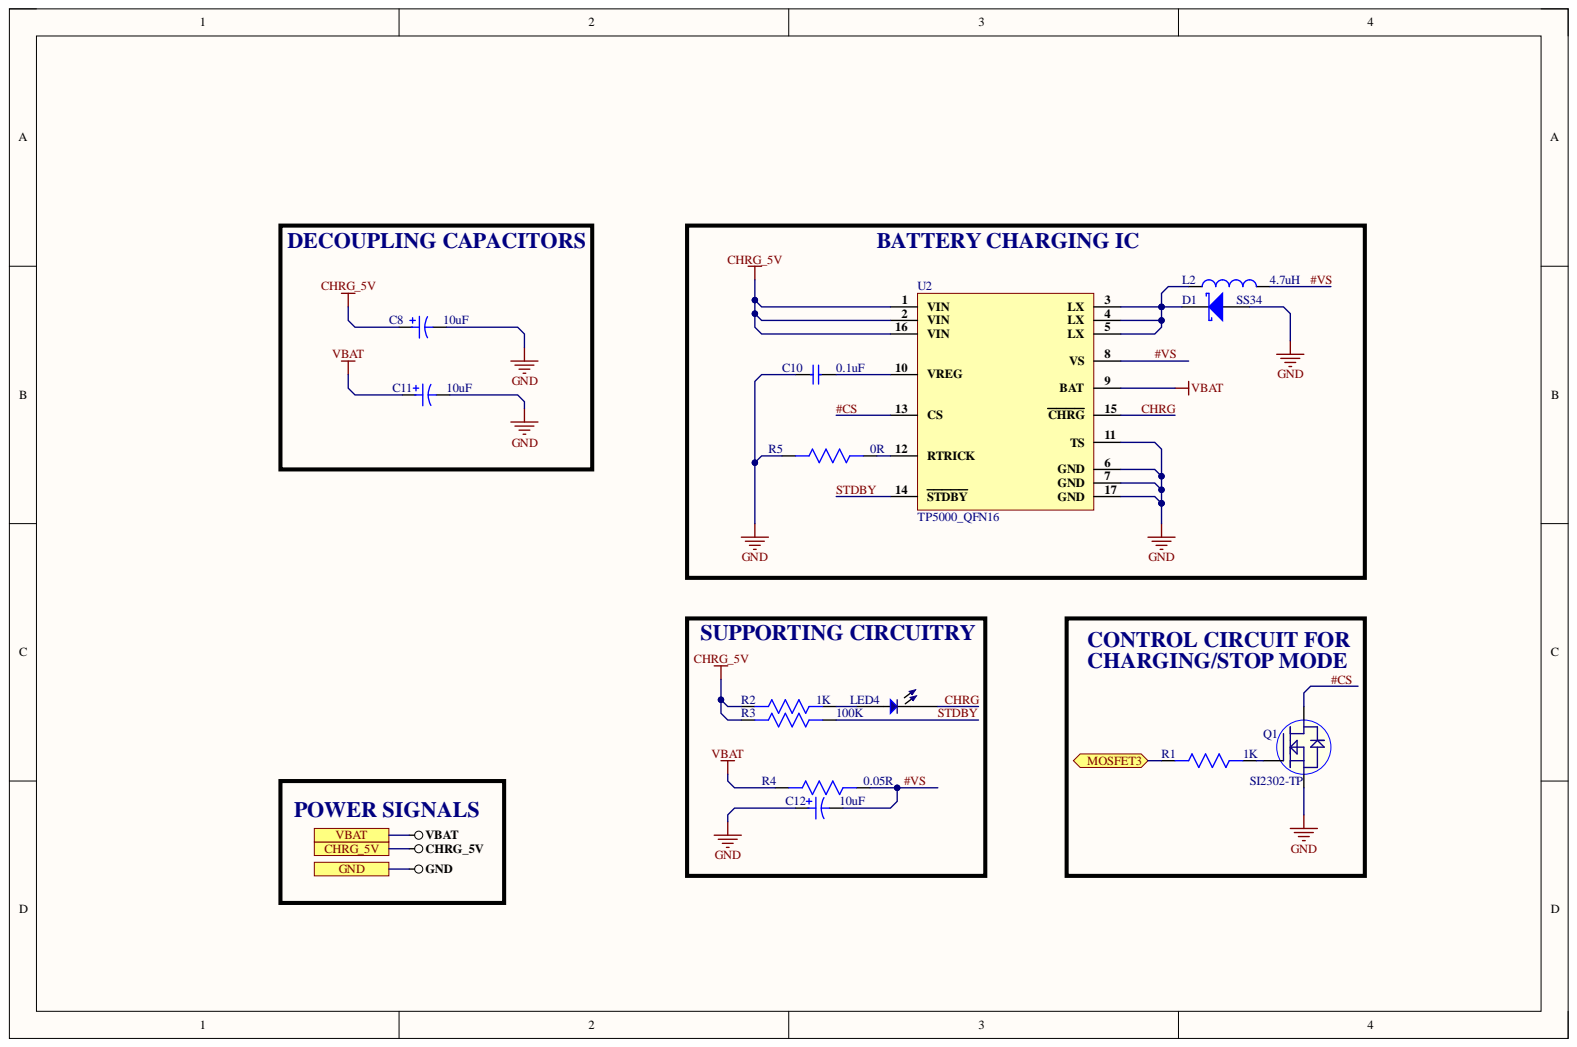
[picture p23: page 3]

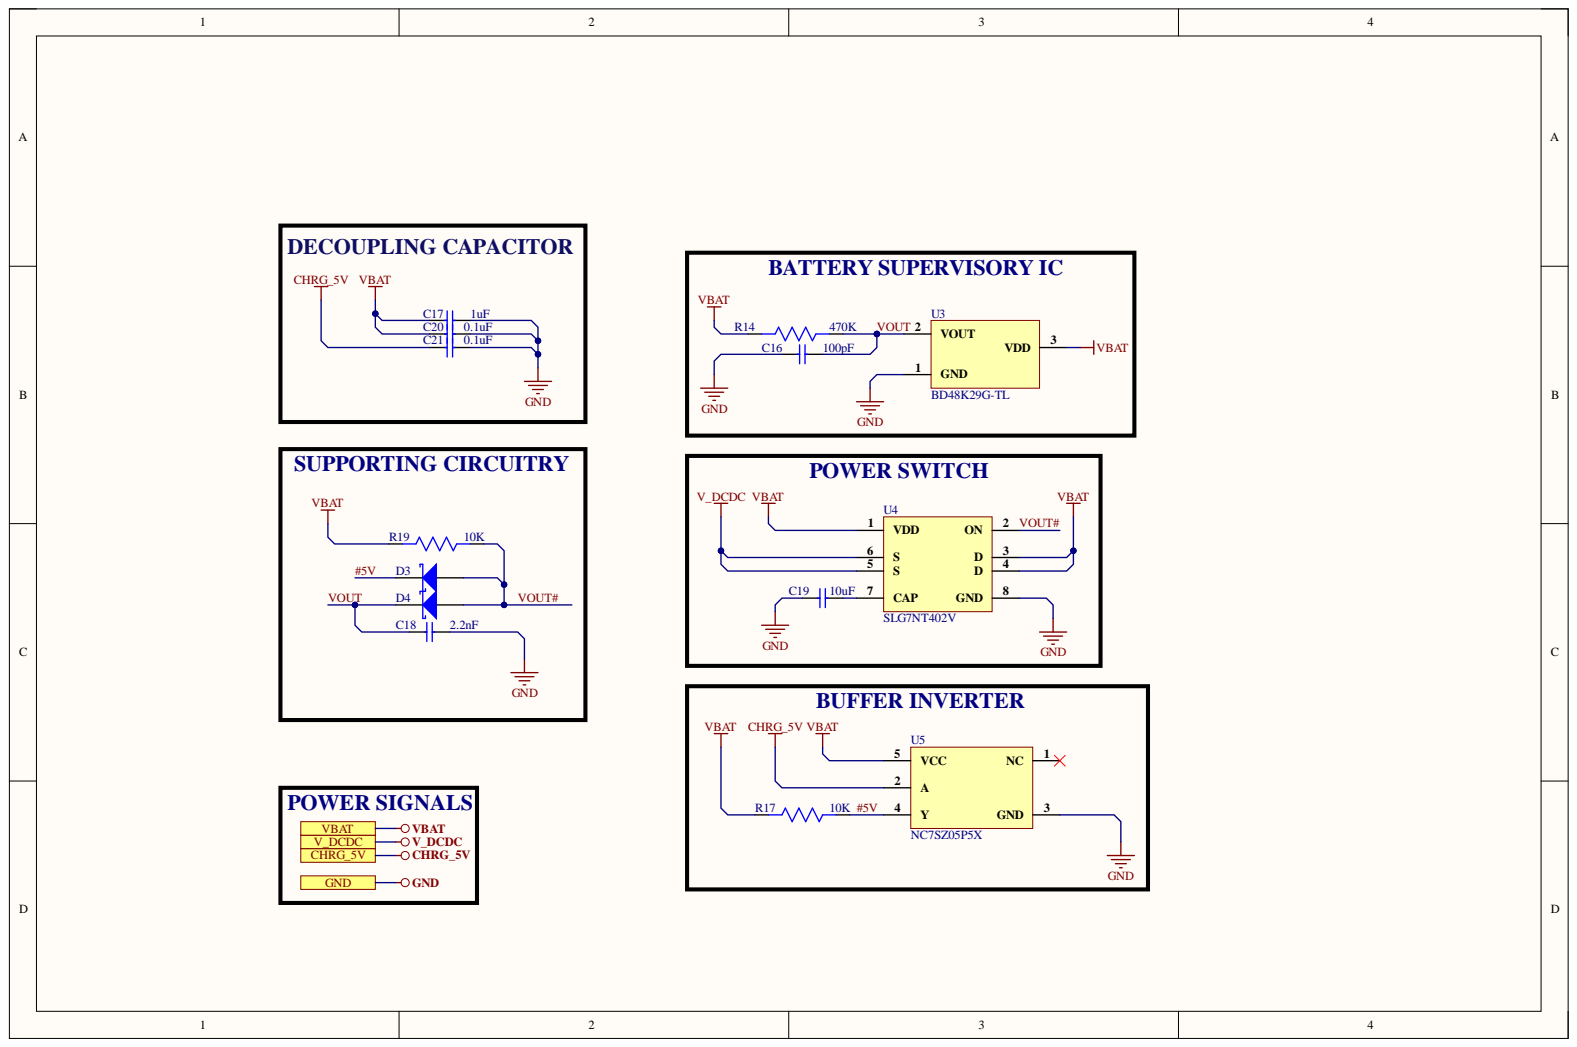
[picture p24: page 4]

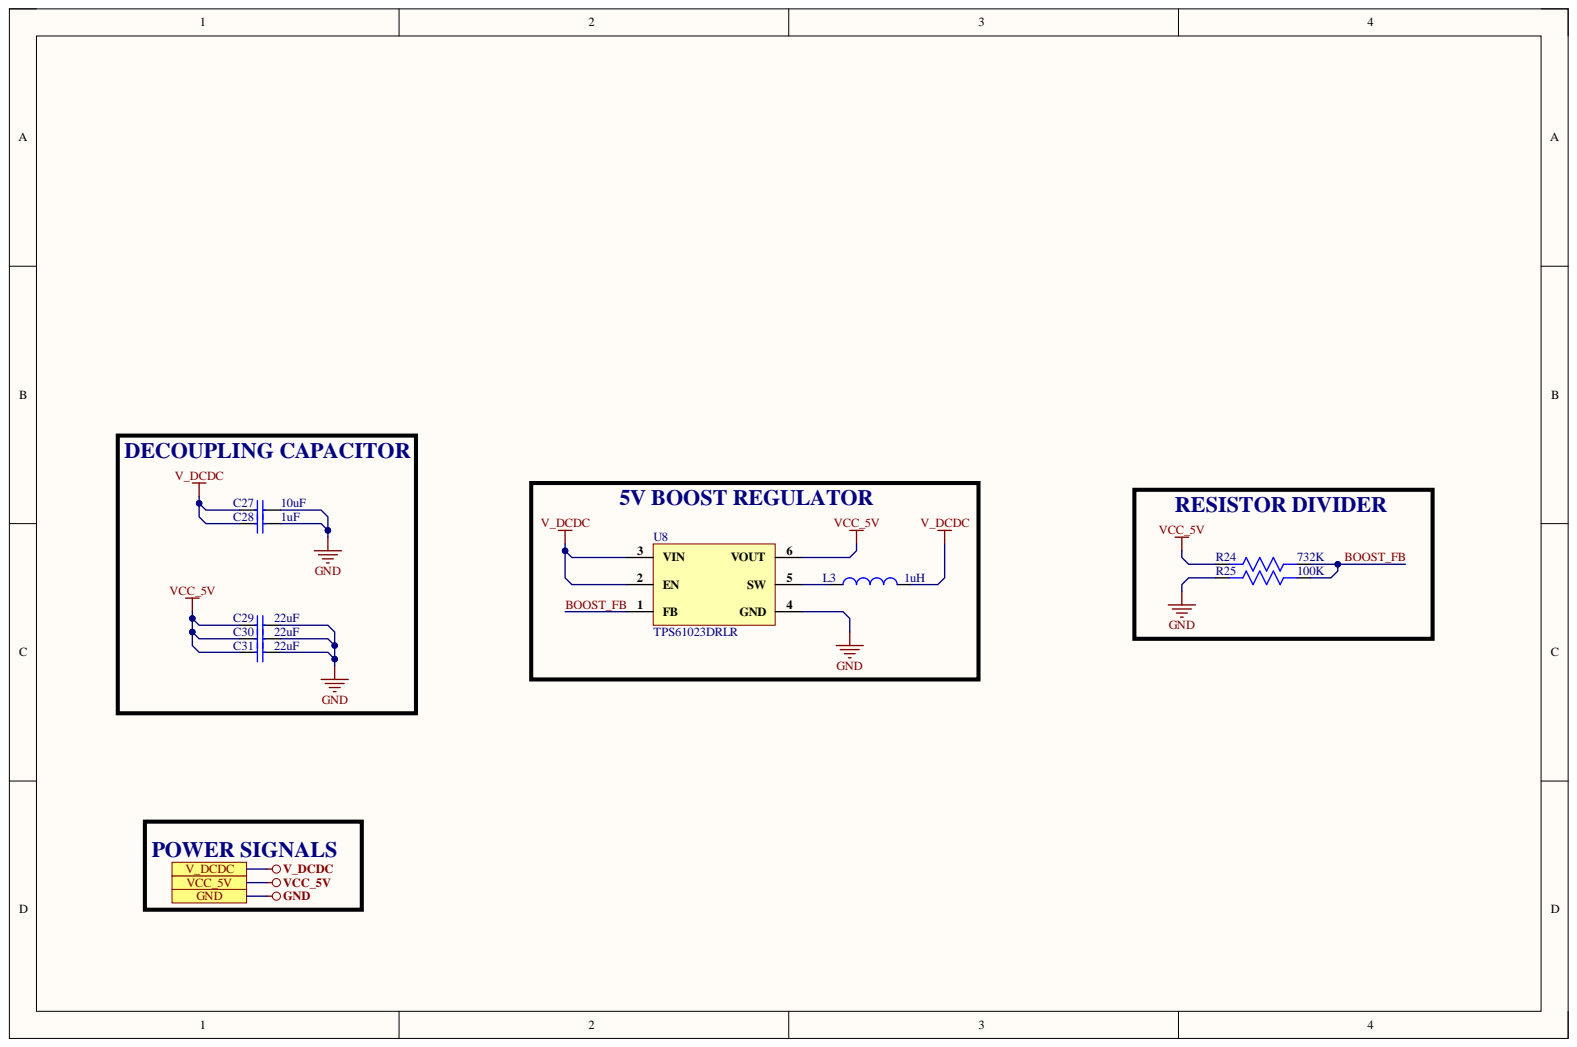
[picture p25: page 5]

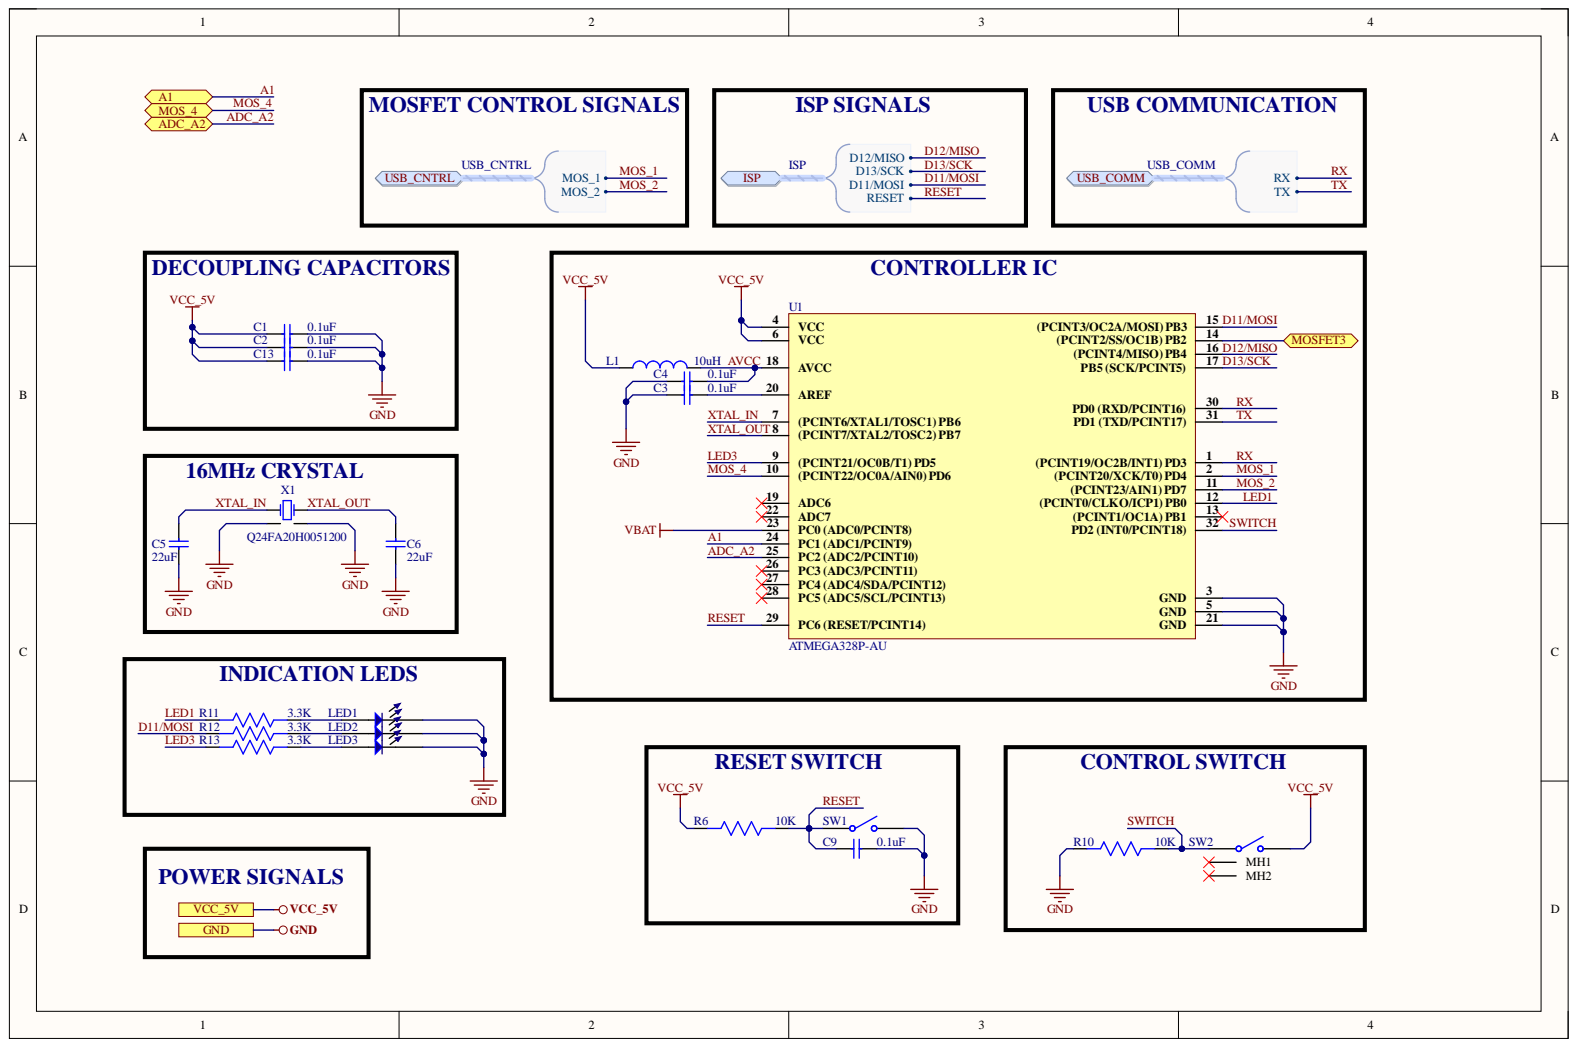
[picture p26: page 6]

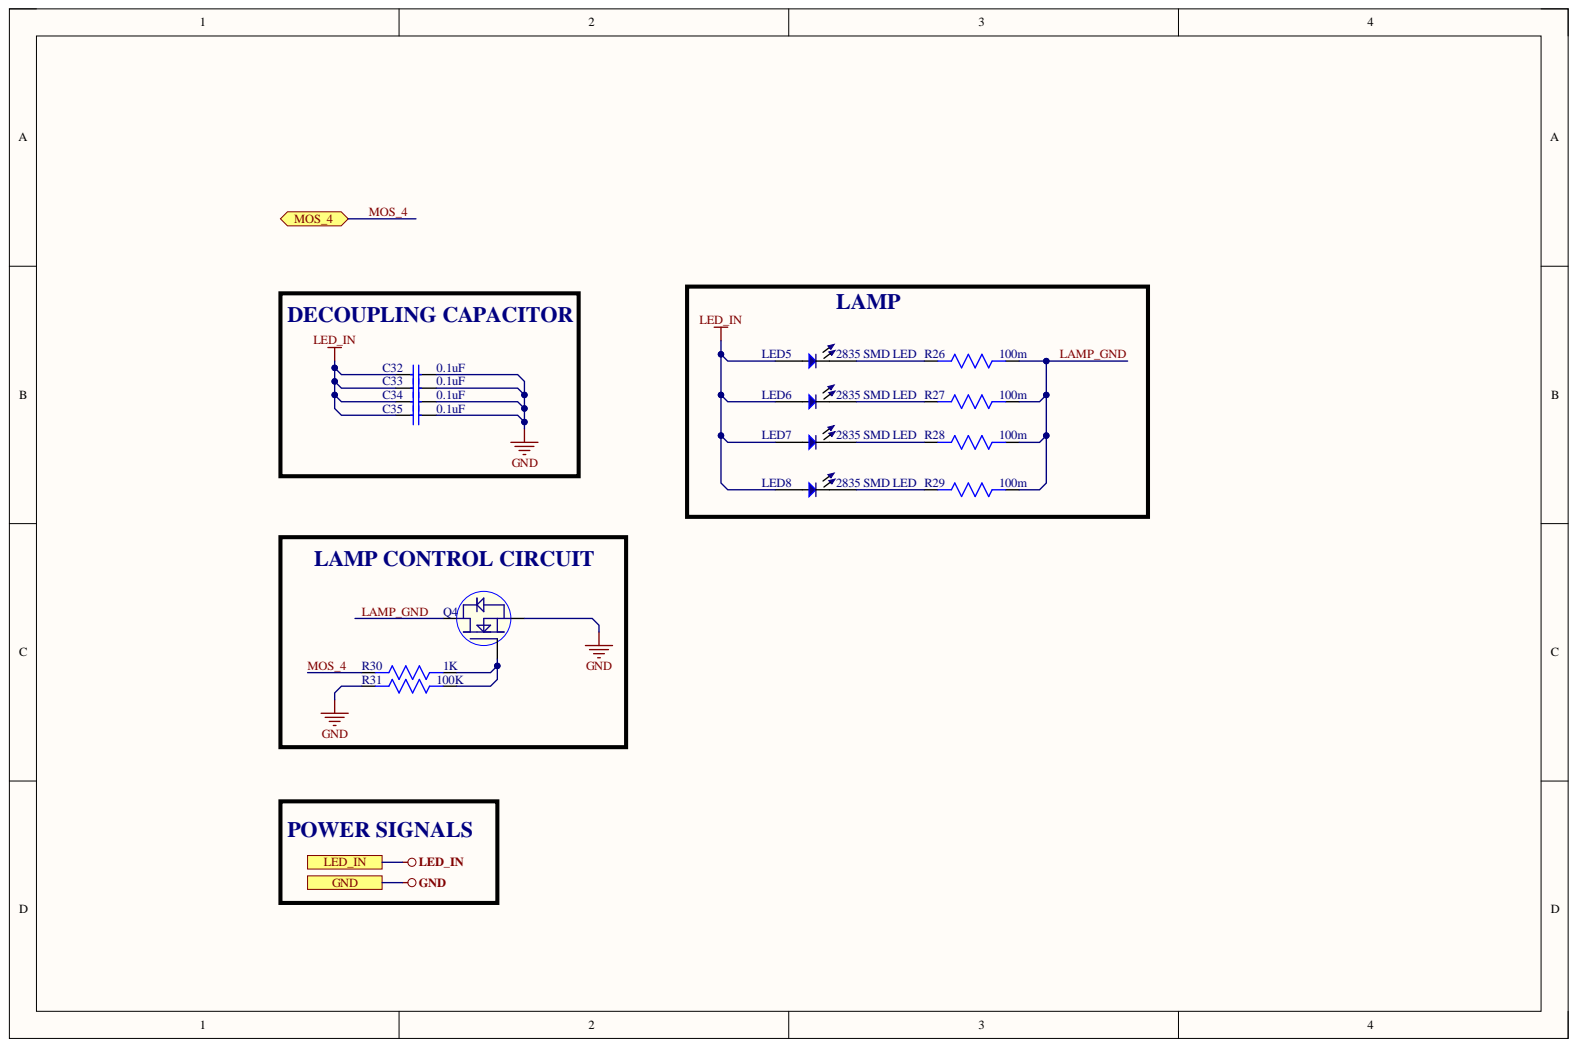
[picture p27: page 7]

LED_IN | LAMP

DECOUPLING CAPACITOR LED_IN

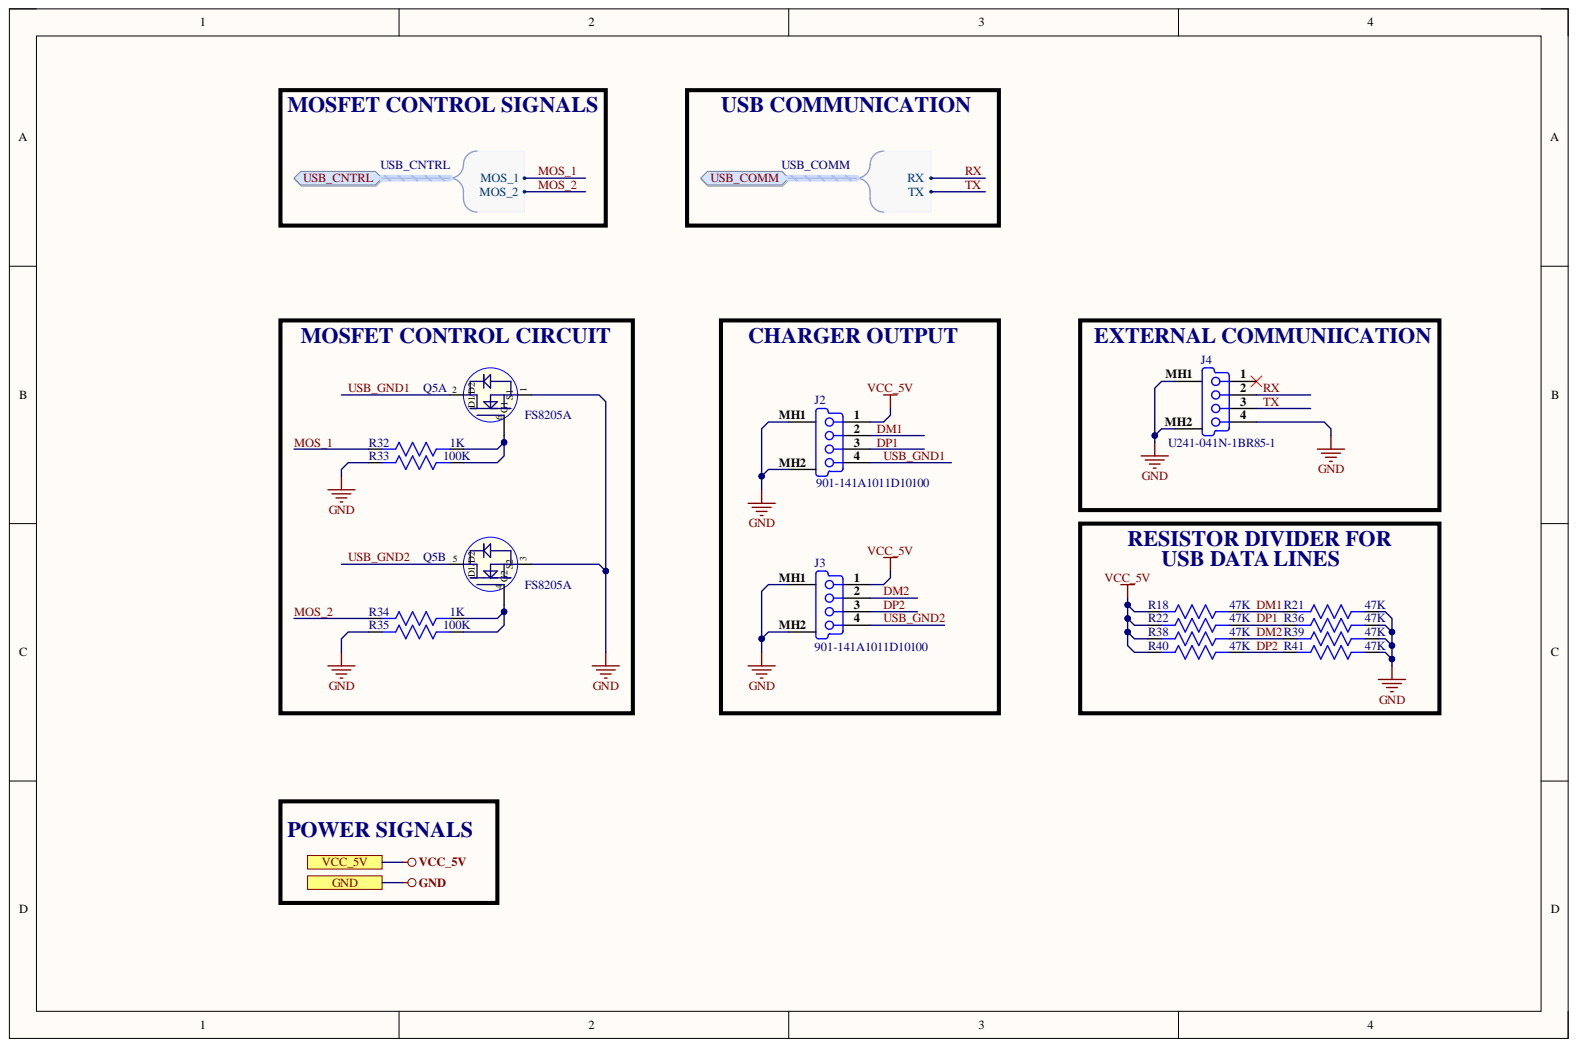
[picture p28: page 8]

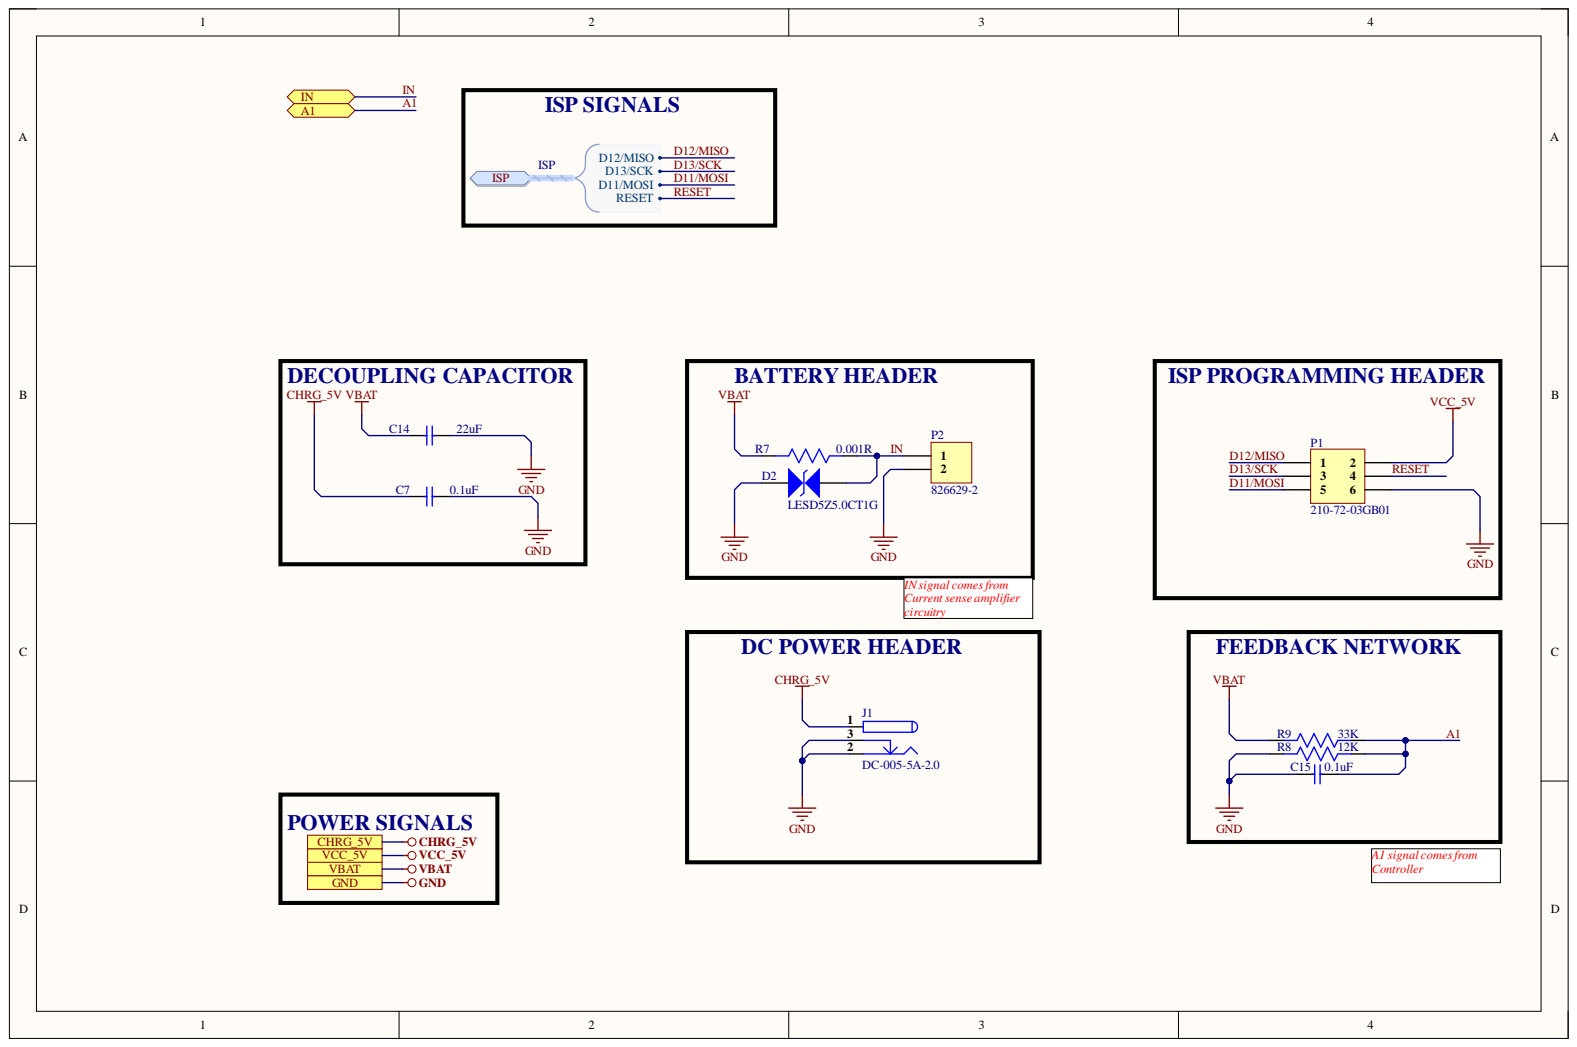
[picture p29: page 9]

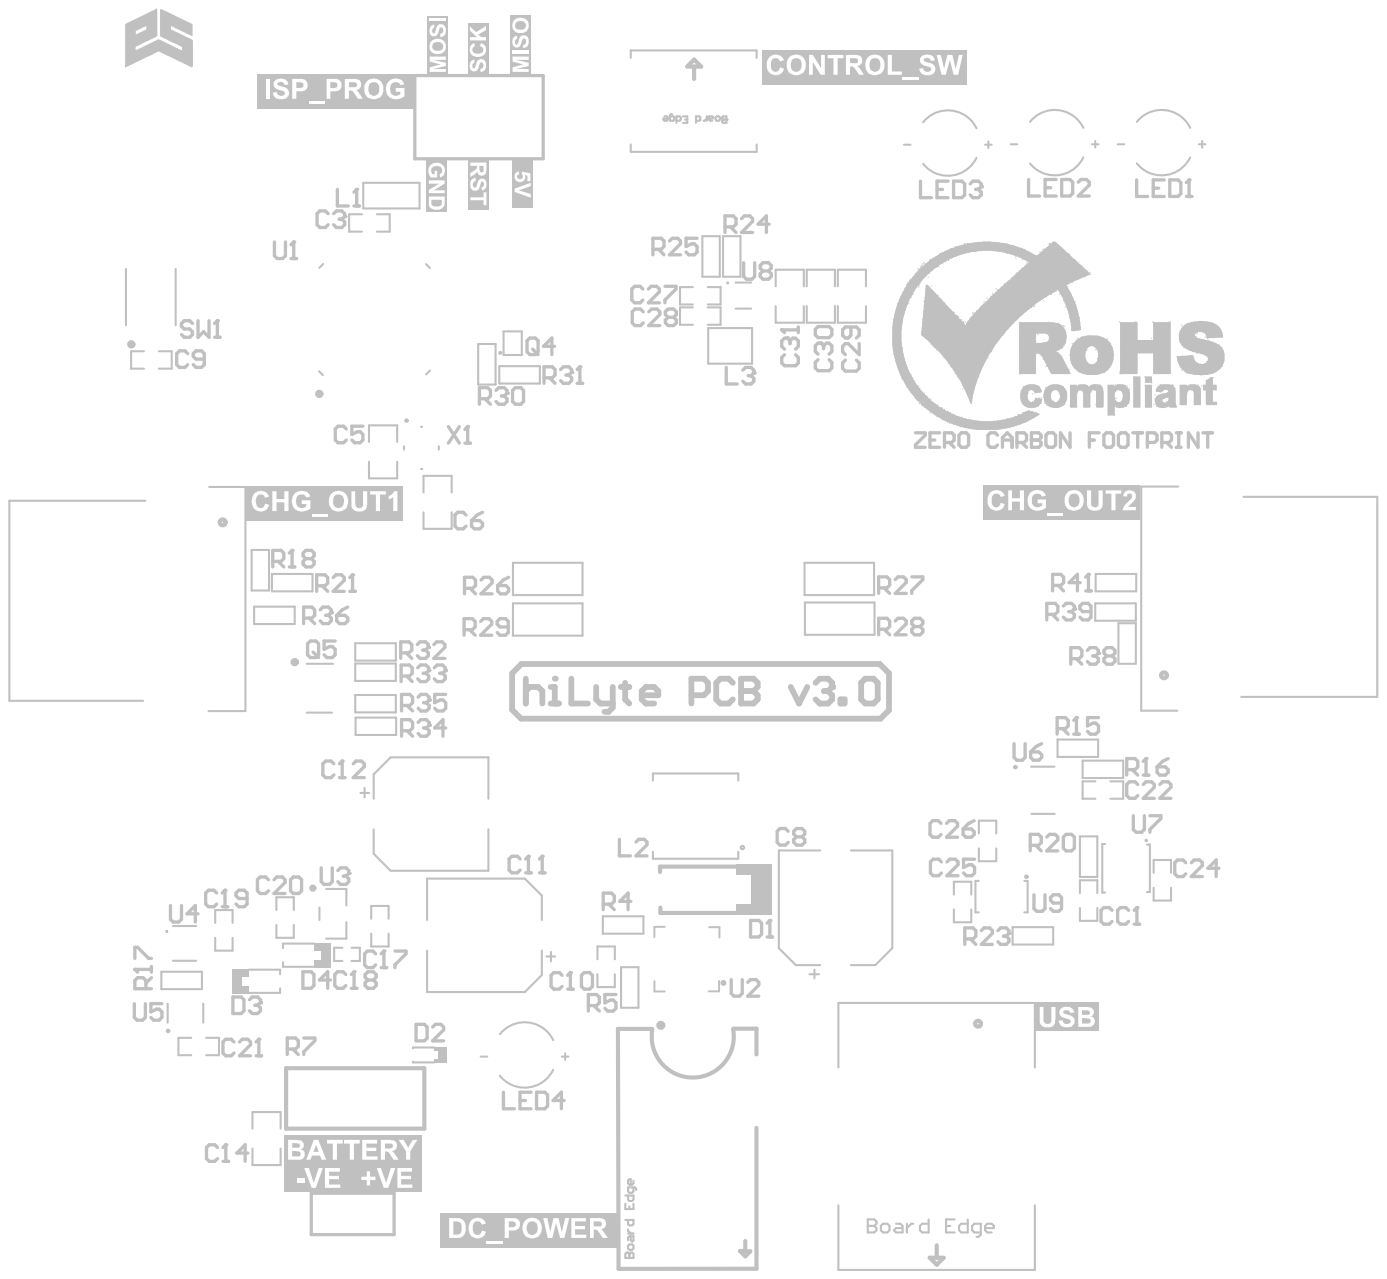
[picture p30: page 10]
