eSpark-Backup/briacbarthes-phonecharger/Documents/Client-Files/PCB_Schematic_Phase3_v1_2.PDF

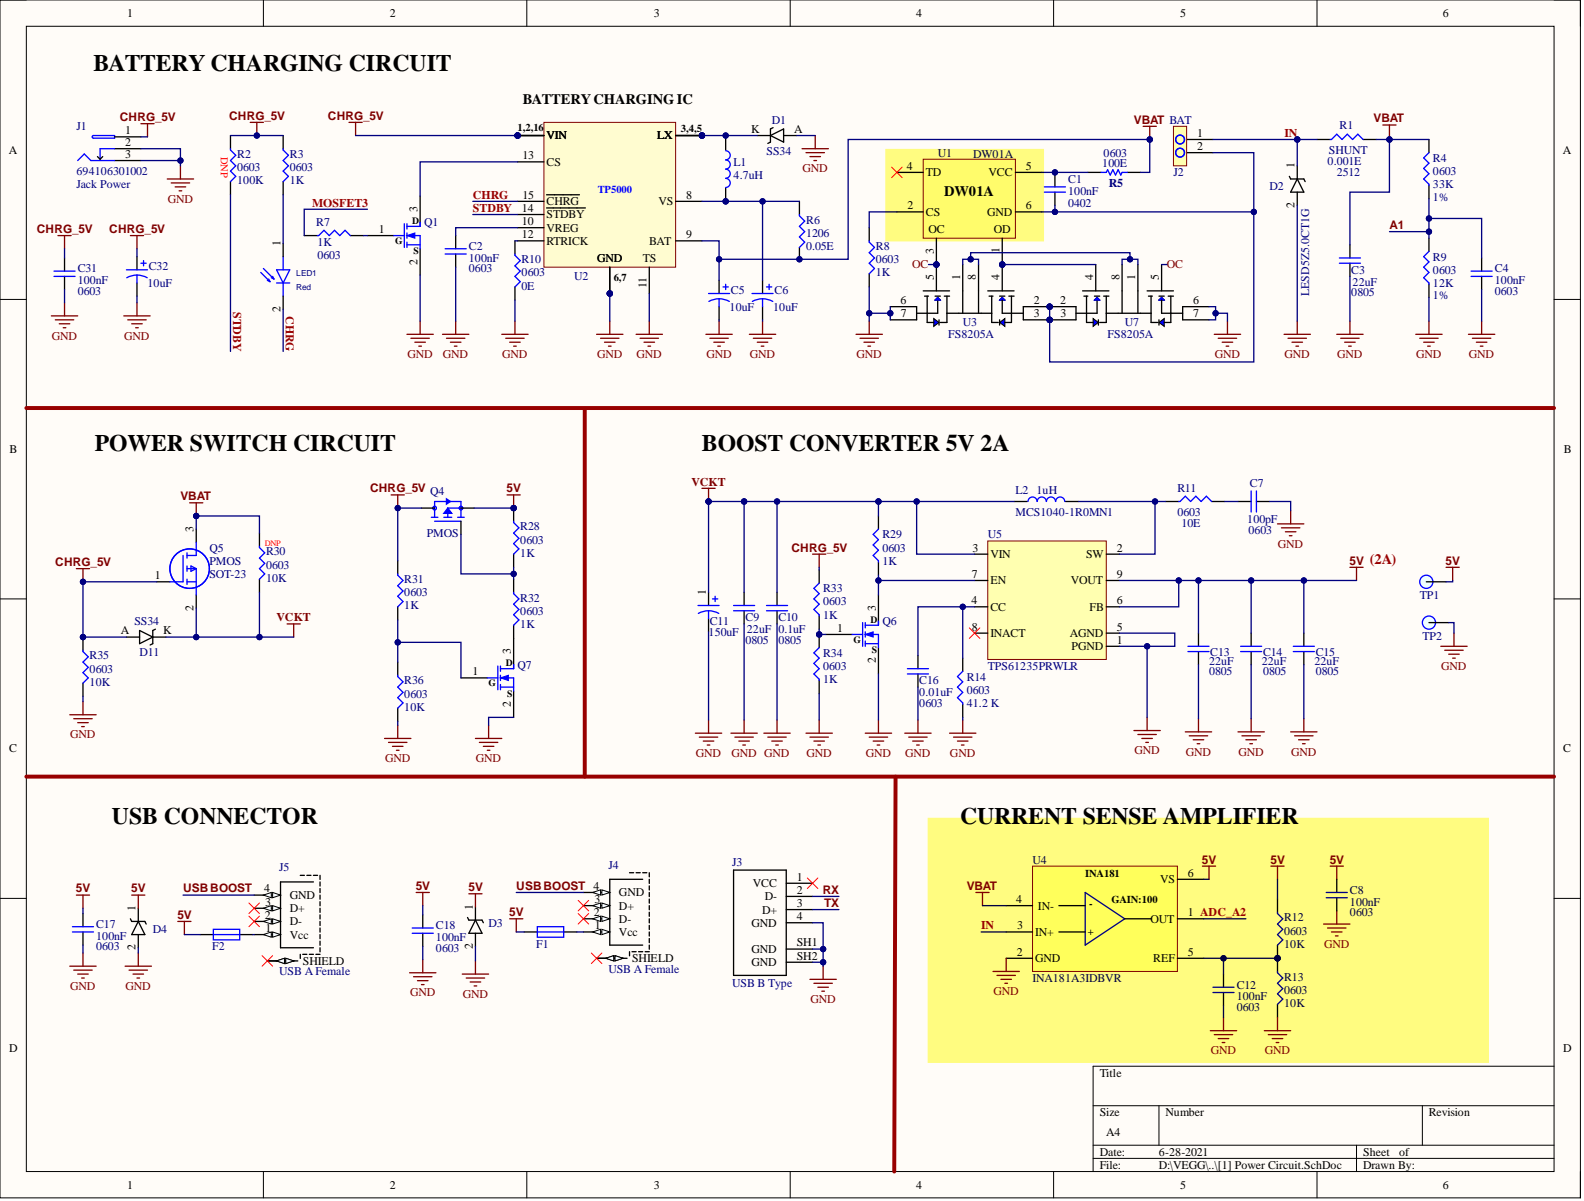
[picture p31: page 1]

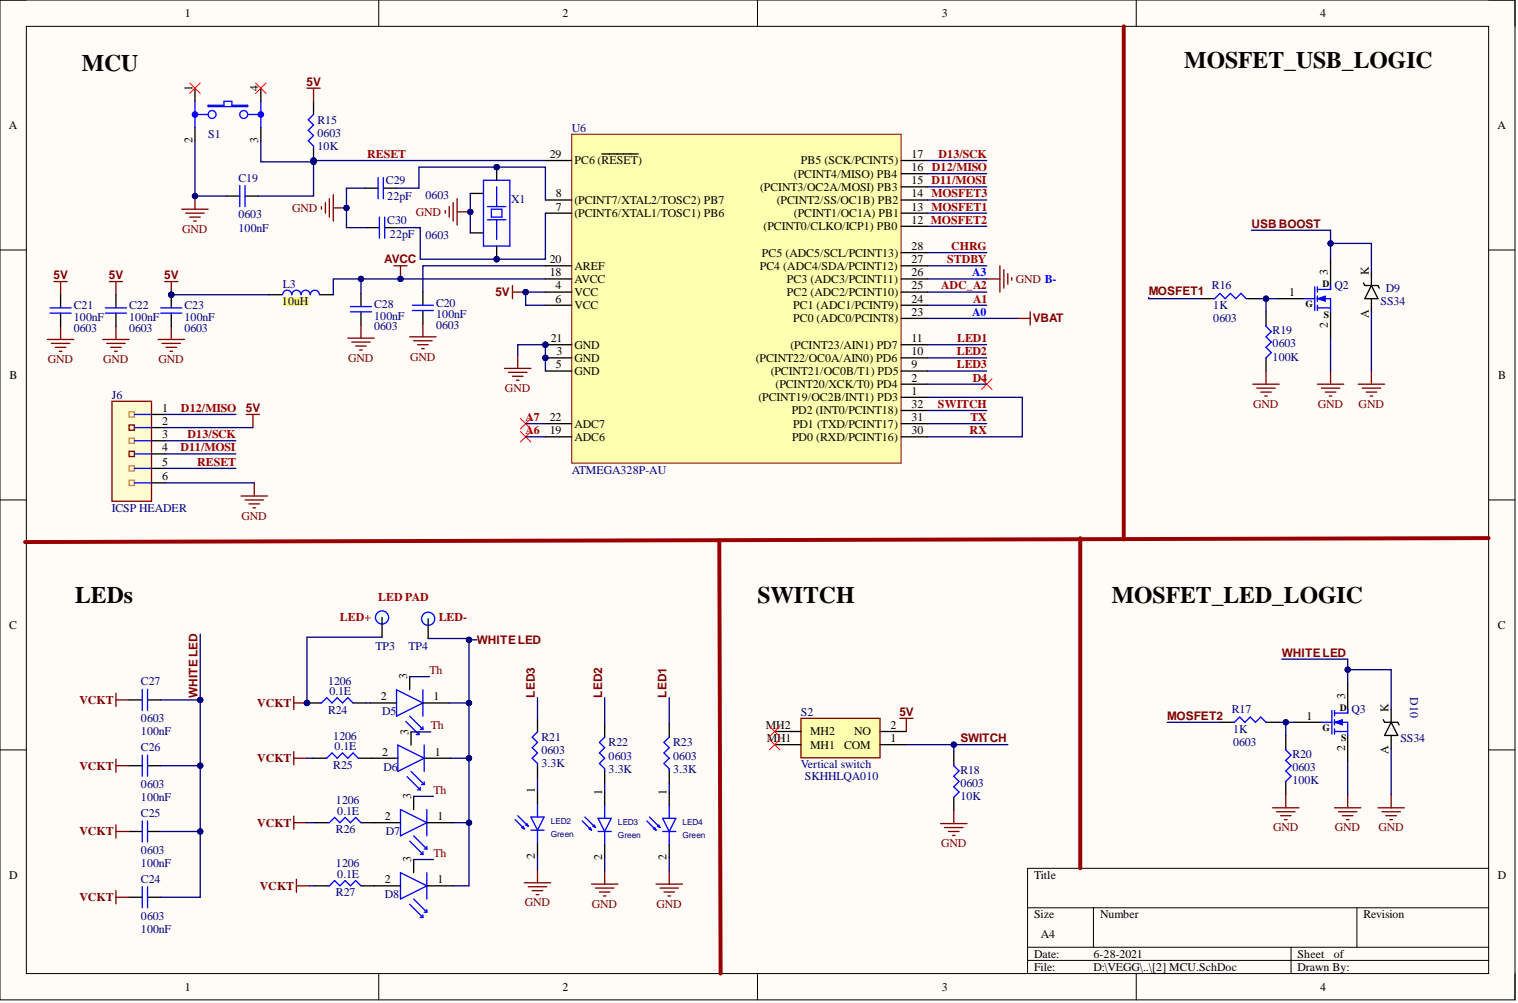
[picture p32: page 2]

MOSFET_USB_LOGIC WHITE LED USB BOOST 0603 100K

1 8
