eSpark-Backup/briacbarthes-phonecharger/(list of files, drawings)

Other design files:
Design-Files/Battery_Charging_Section.SchDoc
Design-Files/Battery_Management_Section.SchDoc
Design-Files/Briac_Charger.PcbDoc
Design-Files/Connector_Section.SchDoc
Design-Files/Controller_Section.SchDoc
Design-Files/DCDC_Conv_Section.SchDoc
Design-Files/Lamp_Section.SchDoc
Design-Files/Phone_Charger.PrjPcb
Design-Files/Power_Section.SchDoc
Design-Files/Top_Sheet.SchDoc
Design-Files/USB_Section.SchDoc
Library-Files/PCB_Lib.PcbLib
Library-Files/SCH_Lib.SchLib
