eSpark-Backup/briacbarthes-phonecharger/(commit log)

2021-10-08 Circuit Issues and Proposed Corrections
2021-10-12 Latest BOM
    [Digikey_BOM.xlsx]
2021-10-20 Part search doc added (in progress)
    [Part Selection.xlsx]
2021-10-21 Part Selection doc updated. Added source selector, power switch and barrel connector.
    [Part Selection.xlsx]
2021-10-22 Client Original BOM and some modification done in Part Selection Sheet
    [BOM_Hilyte_V3_1_1.xlsx, Part Selection.xlsx]
2021-10-22 LED, inverter IC and supervisor IC added.
    [Part Selection.xlsx]
2021-10-25 ATMEGA, TP5000, power LED, 2 USB connectors and DC jack added to lib.
    [Part Selection.xlsx]
2021-11-01 Schematic design of Controller and Battery Charging section(incomplete)
    [Battery_Charging_Section.SchDoc, Connector_Section.SchDoc, Coontroller_Section.SchDoc, Phone_Charger.PrjPcb]
2021-11-02 Schematic of Controller and Battery charging Section
    [Battery_Charging_Section.SchDoc, Connector_Section.SchDoc, Coontroller_Section.SchDoc, Phone_Charger.PrjPcb]
2021-11-02 Schematic of Battery charging and Controller( changes in inductor position)
    [Battery_Charging_Section.SchDoc, Connector_Section.SchDoc, Coontroller_Section.SchDoc]
2021-11-03 Switch and LEDs added in Controller Section
    [Battery_Charging_Section.SchDoc, Connector_Section.SchDoc, Coontroller_Section.SchDoc, Phone_Charger.PrjPcb]
2021-11-07 Schamtic Designing. Changes in library.
    [Battery_Charging_Section.SchDoc, Battery_Management.SchDoc, Briac_Charger.PcbDoc, Connector_Section.SchDoc, Coontroller_Section.SchDoc, Part Selection.xlsx, Phone_Charger.PrjPcb, Top_Sheet.SchDoc]
2021-11-07 Schematic Designing. Changes in library.
    [Battery_Charging_Section.SchDoc, Battery_Management.SchDoc, Connector_Section.SchDoc, Coontroller_Section.SchDoc, DCDC_Conv_Section.SchDoc, Phone_Charger.PrjPcb, Top_Sheet.SchDoc]
2021-11-08 Upated library Resistor ,Cap ,IC Footprint change kr diye han library me
2021-11-09 Power section, connector section and LED lamp completed. Lib added.
    [Battery_Charging_Section.SchDoc, Battery_Management.SchDoc, Connector_Section.SchDoc, Coontroller_Section.SchDoc, DCDC_Conv_Section.SchDoc, Phone_Charger.PrjPcb]
2021-11-09 Generated Design PDF
    [Phone_Charger.PrjPcb]
2021-11-10 Schematic completed and PDF generated.
    [Battery_Charging_Section.SchDoc, Battery_Management.SchDoc, Connector_Section.SchDoc, Controller_Section.SchDoc, Coontroller_Section.SchDoc, DCDC_Conv_Section.SchDoc, Lamp_Section.SchDoc, Phone_Charger.PrjPcb]
2021-11-10 boost IC, source selector and supporting components added in library.
    [Phone_Charger.PrjPcb]
2021-11-11 Changed folder locations
    [Battery_Charging_Section.SchDoc, Briac_Charger.PcbDoc, Connector_Section.SchDoc, Controller_Section.SchDoc, DCDC_Conv_Section.SchDoc, Lamp_Section.SchDoc, Phone_Charger.PrjPcb, Power_Section.SchDoc]
2021-11-11 Compile error removal by changing Project Options
    [Battery_Charging_Section.SchDoc, Briac_Charger.PcbDoc, Connector_Section.SchDoc, Controller_Section.SchDoc, DCDC_Conv_Section.SchDoc, Lamp_Section.SchDoc, Phone_Charger.PrjPcb, Power_Section.SchDoc]
2021-11-11 Parts addition in library and Schematic changes done to replace PMOS combination
    [Power_Section.SchDoc]
2021-11-11 PDF generated for Schematic Design
    [Battery_Charging_Section.SchDoc, Controller_Section.SchDoc, DCDC_Conv_Section.SchDoc, Phone_Charger.PrjPcb, Power_Section.SchDoc]
2021-11-12 Formatting of Schematic Design
    [Battery_Charging_Section.SchDoc, Battery_Management_Section.SchDoc, Connector_Section.SchDoc, Controller_Section.SchDoc, DCDC_Conv_Section.SchDoc, Lamp_Section.SchDoc, Phone_Charger.PrjPcb, Power_Section.SchDoc]
2021-11-12 #7 Digikey BOM completed
    [Digikey_BOM.xlsx]
2021-11-16 BOM review ho gaya ha jin parts LCSC Link Add ha wo highlight kr diye han
    [Digikey_BOM.xlsx]
2021-11-17 Partial BOM Review
    [Digikey_BOM.xlsx]
2021-11-18 @faizi968 BOM Changes ho gaye han Lowest price link add kr diye han Ap check kr len
    [Digikey_BOM.xlsx]
2021-11-21 Client-BOM reviewed. Few parts link changed to cheaper alternates from AliExpress
    [Digikey_BOM.xlsx]
2021-11-21 BOM Filename Changed
    [Client-BOM.xlsx]
2021-12-04 Added schematic review shared by client.
2021-12-06 Schematic changes as per issue #10.
    [Battery_Management_Section.SchDoc, Briac_Charger.PcbDoc, Controller_Section.SchDoc, Power_Section.SchDoc, USB_Section.SchDoc]
2021-12-06 Recent PCB changes saved.
    [Briac_Charger.PcbDoc]
2021-12-06 BOM changes Completed #11
    [Battery_Management_Section.SchDoc, Client-BOM.xlsx, OLD Client BOM.xlsx, Phone_Charger.PrjPcb, Phone_Charger.xlsx]
2021-12-06 PCB Parts Placement (outside the board)
    [Battery_Management_Section.SchDoc, Briac_Charger.PcbDoc, Connector_Section.SchDoc, Power_Section.SchDoc]
2021-12-07 PCB Parts Placement according to reference PCB shared in Client files
    [Battery_Charging_Section.SchDoc, Battery_Management_Section.SchDoc, Briac_Charger.PcbDoc, Connector_Section.SchDoc]
2021-12-08 3B bodies of j4 and D1 is adjusted and Mounting Holes placed in PCB
    [Battery_Charging_Section.SchDoc, Briac_Charger.PcbDoc, USB_Section.SchDoc]
2021-12-22 PCB Routing.
    [Battery_Charging_Section.SchDoc, Battery_Management_Section.SchDoc, Briac_Charger.PcbDoc, Connector_Section.SchDoc, Controller_Section.SchDoc, DCDC_Conv_Section.SchDoc, Lamp_Section.SchDoc, Phone_Charger.PrjPcb]
2021-12-23 PCB Designing.
    [Battery_Charging_Section.SchDoc, Battery_Management_Section.SchDoc, Briac_Charger.PcbDoc, Connector_Section.SchDoc, Controller_Section.SchDoc, DCDC_Conv_Section.SchDoc, Lamp_Section.SchDoc, Power_Section.SchDoc]
2021-12-24 #15 BOM review Complete
    [Client-BOM.xlsx]
2021-12-25 PCB Routing completed. Renderings and Gerbers Remaining.
    [Battery_Charging_Section.SchDoc, Battery_Management_Section.SchDoc, Briac_Charger.PcbDoc, Connector_Section.SchDoc, Controller_Section.SchDoc, DCDC_Conv_Section.SchDoc, Lamp_Section.SchDoc, Phone_Charger.PrjPcb]
2021-12-25 Renderings and supporting files created. Only Gerbers and other Production files are remaining.
    [BOM_LCSC.xlsx, Briac_Charger.DWG, Briac_Charger.DXF, Briac_Charger.PcbDoc, Briac_Charger.step, Client-BOM.xlsx, OLD Client BOM.xlsx]
2021-12-26 Updated files. Gerbers and all production files created.
    [Battery_Charging_Section.SchDoc, Battery_Management_Section.SchDoc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]
2021-12-26 Latest Files after minor changes in PCB.
    [Briac_Charger.DWG, Briac_Charger.DXF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]
2022-01-07 Changes in PCB.
    [Battery_Charging_Section.SchDoc, Battery_Management_Section.SchDoc, Briac_Charger.PcbDoc, Connector_Section.SchDoc, Controller_Section.SchDoc, DCDC_Conv_Section.SchDoc, Lamp_Section.SchDoc, Phone_Charger.PrjPcb]
2022-01-07 Review Done. Fresh Gerbers and production files created.
    [Battery_Charging_Section.SchDoc, Battery_Management_Section.SchDoc, Briac_Charger.DWG, Briac_Charger.DXF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]
2022-01-07 Fresh Gerbers and production files created.
    [Battery_Charging_Section.SchDoc, Battery_Management_Section.SchDoc, Briac_Charger.DWG, Briac_Charger.DXF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]
2022-01-08 #16 Completed
    [LCSC BOM For Quantity 5 Boards .xlsx, Phone_Charger.PrjPcb, Phone_Charger.xlsx]
2022-01-09 Parts update in PCB after library review.
    [Battery_Charging_Section.SchDoc, Battery_Management_Section.SchDoc, Briac_Charger.PcbDoc, Connector_Section.SchDoc, Controller_Section.SchDoc, DCDC_Conv_Section.SchDoc, Lamp_Section.SchDoc, Phone_Charger.PrjPcb]
2022-01-13 #17 Complete
    [Battery_Charging_Section.SchDoc, Battery_Management_Section.SchDoc, Briac_Charger.PcbDoc, Connector_Section.SchDoc, Controller_Section.SchDoc, DCDC_Conv_Section.SchDoc, Lamp_Section.SchDoc, Power_Section.SchDoc]
2022-01-13 #17 SLG7NT402r03 part ki 3d body or footprint change kia ha
    [Battery_Charging_Section.SchDoc, Battery_Management_Section.SchDoc, Briac_Charger.PcbDoc, Connector_Section.SchDoc, Controller_Section.SchDoc, DCDC_Conv_Section.SchDoc, Lamp_Section.SchDoc, Power_Section.SchDoc]
2022-01-14 Client BOM updated for 5,100 and 1000 boards Custom supplier price added.
    [Client-BOM.xlsx, LCSC BOM For Quantity 5 Boards .xlsx]
2022-02-01 Changes done acc: to issue #21
    [Briac_Charger.PcbDoc, Phone_Charger.PrjPcb]
2022-02-01 Review of PCB Done. PCBG Review Folder created on Repo. For Details refer to https://github.com/eSpark-Electronics/BriacBarthes-PhoneCharger/issues/22#issuecomment-1026987548
    [Briac_Charger.PcbDoc, Phone_Charger.PrjPcb, Top_Sheet.SchDoc]
2022-02-14 PCB Routing. Refer to #23 PCB Designing - Finalizing Routing and Placement.
    [Battery_Charging_Section.SchDoc, Battery_Management_Section.SchDoc, Briac_Charger.PcbDoc, Connector_Section.SchDoc, Controller_Section.SchDoc, DCDC_Conv_Section.SchDoc, Lamp_Section.SchDoc, Power_Section.SchDoc]
2022-02-15 Changes done acc #23
    [Briac_Charger.PcbDoc, Controller_Section.SchDoc]
2022-02-15 Review done against "#24 PCB Designing - Review of PCB".
    [Battery_Charging_Section.SchDoc, Battery_Management_Section.SchDoc, Briac_Charger.PcbDoc, Connector_Section.SchDoc, Controller_Section.SchDoc, DCDC_Conv_Section.SchDoc, Lamp_Section.SchDoc, Power_Section.SchDoc]
2022-02-15 Corrections in PCB done after Review. Refer to #24
    [Battery_Charging_Section.SchDoc, Battery_Management_Section.SchDoc, Briac_Charger.PcbDoc, Connector_Section.SchDoc, Controller_Section.SchDoc, DCDC_Conv_Section.SchDoc, Lamp_Section.SchDoc, Power_Section.SchDoc]
2022-02-23 Complete Project files from @SidraEssani pushed
    [Briac_Charger.DWG, Briac_Charger.DXF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]
